littleweirdo-studio/little-squeaky-machine-hardware/docs/specs.md

The Little Squeaky Machine is a hardware reference platform for the [Little Weirdo software synthesizer](https://github.com/hi-squeaky-things/little-weirdo).

## Background

We were part of the Dutch house scene in the '90s, building real-time hardware and software for music and game projects. As electronic music enthusiasts, we couldn't help collecting phat-sounding synthesizers.

Decades later, we still love electronic music, even though we sold our synthesizer collection—a decision we regret. We wanted to create affordable, open-source electronic instruments that are accessible to everyone. By combining Rust (❤️ :fontawesome-brands-rust:) with low-cost microcontrollers (:simple-espressif: ESP32S3 / :simple-riscv: based ESP32S31), we aim to get into the groove and give back to the community.

With this in mind, we designed and built the hardware and software.

## Little Squeaky Machine Hardware

### Specifications and capabilities

| Subsystem | Component | Description |
| --- | --- | --- |
| Microcontroller | [ESP32-S3-WROOM-1](https://documentation.espressif.com/esp32-s3-wroom-1_wroom-1u_datasheet_en.pdf) | Runs the Little Weirdo firmware and manages the device's sound generation and controls. The MCU has two cores clocked at 240 MHz, making it well suited to separating sound generation, powered by the [Little Weirdo software synthesizer](https://github.com/hi-squeaky-things/little-weirdo), from control tasks. |
| Audio codec | [SGTL5000](https://www.nxp.com/docs/en/data-sheet/SGTL5000.pdf) | Provides stereo line input and output, microphone input with bias, and a capless stereo headphone amplifier with mixing and filtering. Its mixing matrix makes it easy to route microphone and line inputs into the audio signal chain. The SGTL5000 also includes digital filters for EQ and virtual surround sound. |
| Capacitive touch | [CY8CMBR3108](https://www.infineon.com/assets/row/public/documents/30/49/infineon-cy8cmbr3002-cy8cmbr3102-cy8cmbr3106s-cy8cmbr3108-cy8cmbr3110-cy8cmbr3116-datasheet-en.pdf) | Provides eight capacitive touch inputs over I²C, accessible through an edge connector. |
| TRS MIDI | [ESP32-S3-WROOM-1](https://documentation.espressif.com/esp32-s3-wroom-1_wroom-1u_datasheet_en.pdf) | Supports MIDI communication through TRS-A connections. |
| USB MIDI | [ESP32-S3-WROOM-1](https://documentation.espressif.com/esp32-s3-wroom-1_wroom-1u_datasheet_en.pdf) | Supports MIDI communication over USB-C. |
| Potentiometers and encoders | [ESP32-S3-WROOM-1](https://documentation.espressif.com/esp32-s3-wroom-1_wroom-1u_datasheet_en.pdf) | Provides hands-on controls, including four rotary encoders. |
| Motion sensor | [STK8321](https://uploadcdn.oneyac.com/attachments/files/brand_pdf/sensortek/STK8321.pdf) | Measures acceleration along three axes and communicates over I²C. |
| Keys | [CPG151101S11](https://www.lcsc.com/datasheet/C41430893.pdf) | Provides 25 hot-swappable tactile switches. |
| Display | [HS HS96L01W4S03](https://www.lcsc.com/datasheet/C5139758.pdf) | 0.96-inch OLED display with an SSD1315 controller and an I²C interface. |

## Schematics

The schematic source files and PCB layout (available for EasyEDA or KiCAD) can be found in the [:fontawesome-brands-github: Little Squeaky Machine Hardware repository](https://github.com/littleweirdo-studio/little-squeaky-machine-hardware/tree/main/fabrication).

### Processing

This schematic covers the ESP32-S3 and its supporting circuitry, including a USB-C-compliant interface, electrostatic discharge (ESD) and electromagnetic compatibility (EMC) protection, boot and reset buttons, and an OLED display. A resettable fuse provides additional protection for the 5 V rail that supplies the full-color LEDs.

Processing schematic

### Audio codec

This schematic shows the SGTL5000 audio codec and its supporting circuitry, including connectors, internal and external microphones, and a low-power, low-noise power supply.

Audio codec schematic

### LED controls

This schematic covers the circuitry used to control the machine's full-color LEDs.

LED controls schematic

### Key matrix controls

This schematic shows the key matrix and its connections to the 25 hot-swappable tactile switches.

Key matrix controls schematic

### Potentiometer and encoder controls

This schematic shows the connections for the four rotary encoders.

Potentiometer and encoder controls schematic

### MIDI input and output

This schematic covers the TRS-A MIDI input and output connections.

MIDI input and output schematic

### Touch controls

This schematic shows the capacitive touch controller and its connections, including the touch inputs accessible through the edge connector.

Touch controls schematic

### Motion sensing

This schematic shows the STK8321 three-axis accelerometer and its I²C connection.

Motion sensing schematic
