littleweirdo-studio/little-squeaky-machine-hardware/fabrication/v4/BOM_LttLMachineV4-Assembly-Order.xls

JLCPCB BOM Tool - BOM Matching
BOM name：BOM_LttLMachineV4-JLCPCB Assembly Order.xlsx |  |  | Download Time：2026-11-02 03:16:32 |  |  |  | * Our matching results are updated in real-time, but stock and prices may change. If it's been over 24 hours, please re-match before placing your order.
PCB Assembled Qty：5 |  |  | Est. Total Price：63.0858
Your BOM |  |  |  | Matched Parts |  |  |  |  |  |  | Order Information
Designator | Comment | Footprint | JLCPCB Part # | Matches | Part # | Manufacturer | Footprint | Description | Category | Warning | JLCPCB Part # | Product link | Lib Type | Qty | Source | Total Price ($)
C7 | 10uF | C0603 |  | Select by System | CGA0603X5R106K100JT | HRE | 0603 | 10V 10uF X5R ±10% 0603 Multilayer Ceramic Capacitors MLCC - SMD/SMT ROHS | Multilayer Ceramic Capacitors MLCC - SMD/SMT |  | C6119842 | https://jlcpcb.com/partdetail/HRE-CGA0603X5R106K100JT/C6119842 | Extended | 20 | 20 JLCPCB | 0.316
C8,C11,C16,C17,C20,C21,C29,C38,C39,C41,C45,CMIDI,CLED1,CLED2,CLED3,CLED4,CLED5,CLED6,CLED7,CLED8,CLED9,CLED10,CLED11,CLED12,CLED13,CLED14,CLED15,CLED16,CLED17,CLED18,CLED19,CLED20,CLED21,CLED22,CLED23,CLED24,CLED25,CLED26,CLED27,CLED28,CLED29 | 100nF | C0402 |  | Select by Customer | CL05B104KO5NNNC | Samsung Electro-Mechanics | 0402 | 100nF 16V X7R ±10% 0402 Multilayer Ceramic Capacitors MLCC - SMD/SMT ROHS | Multilayer Ceramic Capacitors MLCC - SMD/SMT | 1.There may be multiple types of parts, but one type of part has been matched. Please check.; | C1525 | https://jlcpcb.com/partdetail/1877-CL05B104KO5NNNC/C1525 | Basic | 225 | 225 JLCPCB | 0.72
C9,C35,C36,C37,C40 | 1uF | C0201 |  | Select by System | GRM033R61A105ME44D | Murata Electronics | 0201 | 10V 1uF X5R ±20% 0201 Multilayer Ceramic Capacitors MLCC - SMD/SMT ROHS | Multilayer Ceramic Capacitors MLCC - SMD/SMT |  | C76935 | https://jlcpcb.com/partdetail/MurataElectronics-GRM033R61A105ME44D/C76935 | Extended | 37 | 37 JLCPCB | 0.9287
C12,C14,C44 | 10uF | CASE-A_3216 |  | Select by System | CA45-A010M106T | Hunan Xiangyee in S&T | CASE-A-3216-16(mm) | -55℃~+125℃ 10V 10uF 3Ω@100kHz ±20% CASE-A-3216-16(mm) Tantalum Capacitors ROHS | Tantalum Capacitors |  | C127946 | https://jlcpcb.com/partdetail/Hunan_Xiangyee_in_ST-CA45A010M106T/C127946 | Extended | 19 | 19 JLCPCB | 2.1071
C13,C15 | 22uF | CASE-A_3216 |  | Select by System | CA45-A-10V-22uF-K | CEC(Shenzhen Zhenhua XinYun Elec) | CASE-A-3216-16(mm) | -55℃~+125℃ 10V 10Ω@100kHz 22uF ±10% CASE-A-3216-16(mm) Tantalum Capacitors ROHS | Tantalum Capacitors |  | C129272 | https://jlcpcb.com/partdetail/140558-CA45_A_10V_22uFK/C129272 | Extended | 14 | 14 JLCPCB | 1.8018
C18,C19,C25,C26,C27,C28,C30 | 2.2uF | C0402 |  | Select by System | CGA0402X5R225M6R3GT | HRE | 0402 | 2.2uF 6.3V X5R ±20% 0402 Multilayer Ceramic Capacitors MLCC - SMD/SMT ROHS | Multilayer Ceramic Capacitors MLCC - SMD/SMT |  | C7503516 | https://jlcpcb.com/partdetail/HRE-CGA0402X5R225M6R3GT/C7503516 | Extended | 45 | 45 JLCPCB | 0.198
C22 | 150nF | C0402 |  | Select by System | TCC0402X7R154K160AT | CCTC | 0402 | 150nF 16V X7R ±10% 0402 Multilayer Ceramic Capacitors MLCC - SMD/SMT ROHS | Multilayer Ceramic Capacitors MLCC - SMD/SMT |  | C7393865 | https://jlcpcb.com/partdetail/CCTC-TCC0402X7R154K160AT/C7393865 | Extended | 20 | 20 JLCPCB | 0.066
C43 | 2.2nF | C0805 |  | Select by System | CL21C222JBFNNNE | Samsung Electro-Mechanics | 0805 | 2.2nF 50V C0G ±5% 0805 Multilayer Ceramic Capacitors MLCC - SMD/SMT ROHS | Multilayer Ceramic Capacitors MLCC - SMD/SMT |  | C28260 | https://jlcpcb.com/partdetail/29010-CL21C222JBFNNNE/C28260 | Basic | 9 | 9 JLCPCB | 0.3033
C46 | 10nF | C0603 |  | Select by System | CGA0603X7R103M500JT | HRE | 0603 | 10nF 50V X7R ±20% 0603 Multilayer Ceramic Capacitors MLCC - SMD/SMT ROHS | Multilayer Ceramic Capacitors MLCC - SMD/SMT |  | C36911427 | https://jlcpcb.com/partdetail/HRE-CGA0603X7R103M500JT/C36911427 | Extended | 20 | 20 JLCPCB | 0.082
CODEC | SGTL5000XNLA3R2 | QFN-20_L3.0-W3.0-P0.40-BL-EP1.7 |  | Select by System | SGTL5000XNLA3R2 | NXP Semicon | QFN-20-EP(3x3) | -40℃~+85℃ 1.62V~3.6V 8kHz~96kHz Built-in phase-locked loop、On-chip digital gain、Mute control Encoder/decoder I2S、I2C、SPI QFN-20-EP(3x3) Audio Interface ICs ROHS | Audio Interface ICs |  | C2651833 | https://jlcpcb.com/partdetail/NXPSemicon-SGTL5000XNLA3R2/C2651833 | Extended | 5 | 5 My Parts | 0
D1 | SS34 | SMA_L4.3-W2.6-LS5.2-RD |  | Select by System | SS34 | MDD(Microdiode Semiconductor) | SMA(DO-214AC) | -55℃~+125℃ 3A 40V 500uA@40V 550mV@3A Independent SMA(DO-214AC) Schottky Diodes ROHS | Schottky Diodes |  | C8678 | https://jlcpcb.com/partdetail/MDD_Microdiode_Semiconductor-SS34/C8678 | Basic | 13 | 13 JLCPCB | 0.4576
D2 | 1N914W | SOD-123_L2.7-W1.6-LS3.7-RD-1 |  | Select by System | 1N914W | CBI | SOD-123 | 100V 1V@10mA 200mA 400mW 50ns 5uA@75V Independent SOD-123 Switching Diodes ROHS | Switching Diodes |  | C2836060 | https://jlcpcb.com/partdetail/CBI-1N914W/C2836060 | Extended | 20 | 20 JLCPCB | 0.22
D3,D4,D5,D6,D7 | ESD5451N | DFN1006-2L-BI |  | Select by System | ESD5451N | FUXINSEMI | DFN1006-2L | -55℃~+125℃ 1 100nA 11V 15pF 5.6V 5V 80W@8/20us 8A@8/20us Bidirectional IEC 61000-4-2、IEC 61000-4-5 TVS DFN1006-2L ESD and Surge Protection (TVS/ESD) ROHS |  |  | C20418114 | https://jlcpcb.com/partdetail/FUXINSEMI-ESD5451N/C20418114 | Extended | 35 | 35 JLCPCB | 0.1225
EDGE_CONNECTOR | X2549WR-2x10A-PTV01 | CONN-TH_20P-P2.54_X2549WR-2X10A-PTV01 |  | Select by System | X2549WR-2x10A-PTV01 | XKB Connection | 弯插,P=2.54mm | -55℃~+85℃ 14.5mm 2.54mm 20P 32mm 3A 9.2mm Copper Alloy Gold Right Angle Push-Pull,P=2.54mm Edgeboard Connectors ROHS | Edgeboard Connectors |  | C21261721 | https://jlcpcb.com/partdetail/XKBConnection-X2549WR_2x10APTV01/C21261721 | Extended | 5 | 5 My Parts | 0
ENCO0,ENCO1,ENCO2,ENCO3 | EC12E24404A8 | SW-TH_EC12EXXXX |  | Select by System | EC12E24404A8 | ALPSALPINE | 插件 | 插件 Rotary Encoders ROHS | Rotary Encoders |  | C470600 | https://jlcpcb.com/partdetail/ALPSALPINE-EC12E24404A8/C470600 | Extended | 20 | 20 JLCPCB | 11.484
ESP32S3 | ESP32-S3-WROOM-1-N16R8 | WIRELM-SMD_ESP32-S3-WROOM-1 |  | Select by System | ESP32-S3-WROOM-1-N16R8 | Espressif Systems | SMD,25.5x18mm | -103.5dBm -40℃~+65℃ 2.4GHz 20.5dBm 355mA 3V~3.6V 95mA ESP32-S3R8 On-board PCB Antenna UART、SPI、I2C、GPIO、I2S、USB SMD,25.5x18mm WiFi Modules ROHS | WiFi Modules |  | C2913202 | https://jlcpcb.com/partdetail/3198300-ESP32_S3_WROOM_1N16R8/C2913202 | Extended | 5 | 5 My Parts | 0
FUSE | SMD1812-300C-16V | F1812 |  | Select by System | SMD1812-300C-16V | BNstar | 1812 | -40℃~+85℃ 1.5mm 100A 10mΩ 16V 3.41mm 3A 4.73mm 40mΩ 4s 6A 800mW 1812 Resettable Fuses ROHS | Resettable Fuses |  | C2760295 | https://jlcpcb.com/partdetail/BNstar-SMD1812_300C16V/C2760295 | Extended | 7 | 7 JLCPCB | 0.6755
GYRO | STK8321 | LGA-12_L2.0-W2.0-P0.50-TR |  | Select by System | STK8321 | SENSORTEK | LGA-12(2x2) | -40℃~+85℃ 1.7V~3.6V 12bit 1uA Accelerometer SPI、I2C X,Y,Z ±8g 运动事件检测 LGA-12(2x2) Accelerometers ROHS | Accelerometers |  | C966924 | https://jlcpcb.com/partdetail/SENSORTEK-STK8321/C966924 | Extended | 5 | 5 JLCPCB | 2.346
HEADPHONE,MIDI-IN,MIDI-OUT | PJ-3062-HD-B | AUDIO-TH_PJ-3062-HD-B |  | Select by Customer | PJ-3062-HD-B | XKB Connection | 插件 | -20℃~+70℃ 12mm 15.01mm 3.5mm Headphone Jack 30V 500mA 9.35mm Black Phosphor bronze Right-Angle TRS Tin Plugin Audio Connectors ROHS | Audio Connectors (Headphones) | 1.There may be multiple types of parts, but one type of part has been matched. Please check.; | C692443 | https://jlcpcb.com/partdetail/XKBConnection-PJ_3062_HDB/C692443 | Extended | 15 | 15 My Parts | 0
KEY_1,KEY_2,KEY_3,KEY_4,KEY_5,KEY_6,KEY_7,KEY_8,KEY_9,KEY_10,KEY_11,KEY_12,KEY_13,KEY_14,KEY_15,KEY_16,KEY_17,KEY_18,KEY_19,KEY_20,KEY_21,KEY_22,KEY_23,KEY_24,KEY_25 | CPG151101S11-16 | SMD_KEYBOARD-SW |  | Select by System | CPG151101S11-16 | HanElectricity | SMD,14.5x5.9mm | 12V 2 3000gf 5,000 cycles SMD,14.5x5.9mm Mechanical Keyboard Shaft ROHS | Mechanical Keyboard Shaft |  | C41430893 | https://jlcpcb.com/partdetail/HanElectricity-CPG151101S1116/C41430893 | Extended | 127 | 127 JLCPCB | 4.699
KEY_D1,KEY_D2,KEY_D3,KEY_D4,KEY_D5,KEY_D6,KEY_D7,KEY_D8,KEY_D9,KEY_D10,KEY_D11,KEY_D12,KEY_D13,KEY_D14,KEY_D15,KEY_D16,KEY_D17,KEY_D18,KEY_D19,KEY_D20,KEY_D21,KEY_D22,KEY_D23,KEY_D24 | 1N4148WS | SOD-323_L1.8-W1.3-LS2.5-RD |  | Select by System | 1N4148WS | Guangdong Hottech | SOD-323 | 1.25V@150mA 150mA 1uA@75V 200mW 2A 4ns 75V Standalone SOD-323 Switching Diodes ROHS | Switching Diodes |  | C181133 | https://jlcpcb.com/partdetail/GuangdongHottech-1N4148WS/C181133 | Extended | 130 | 130 JLCPCB | 1.235
L1 | HCB2012KV-601T20 | L0805 |  | Select by System | HCB2012KV-601T20 | TAI-TECH | 0805 | 600Ω ±25% 0805 Ferrite Beads ROHS | Ferrite Beads |  | C5139902 | https://jlcpcb.com/partdetail/TAITECH-HCB2012KV601T20/C5139902 | Extended | 20 | 20 JLCPCB | 0.494
L2 | BLM15PX330SN1D | L0402 |  | Select by System | BLM15PX330SN1D | Murata Electronics | 0402 | 1 22mΩ 33Ω@100MHz 3A ±25% 0402 Ferrite Beads ROHS | Ferrite Beads |  | C160974 | https://jlcpcb.com/partdetail/MurataElectronics-BLM15PX330SN1D/C160974 | Extended | 20 | 20 JLCPCB | 0.382
LDO | AMS1117-3.3 | SOT-223-4_L6.5-W3.5-P2.30-LS7.0-BR |  | Select by System | AMS1117-3.3 | UMW(Youtai Semiconductor Co., Ltd.) | SOT-223 | -40℃~+125℃ 0.003%Vout 1 1.3V@(1A) 12V 1A 3.3V 5mA 60dB@(120Hz) Fixed Over Current Protection Positive SOT-223 Voltage Regulators - Linear, Low Drop Out (LDO) Regulators ROHS | Voltage Regulators - Linear, Low Drop Out (LDO) Regulators |  | C347222 | https://jlcpcb.com/partdetail/323882-AMS1117_33/C347222 | Extended | 6 | 6 My Parts | 0
LED1,LED2,LED3,LED4,LED5,LED6,LED7,LED8,LED9,LED10,LED11,LED12,LED13,LED14,LED15,LED16,LED17,LED18,LED19,LED20,LED21,LED22,LED23,LED24,LED25,LED26,LED27,LED28,LED29 | SK6812MINI-E | LED-SMD_4P-L3.2-W2.8-LS5.9_SK6812MINI-E |  | Select by System | SK6812MINI-E | OPSCO Optoelectronics | SMD | -40℃~+85℃ 0.6mA 1.78mm 120mcd~240mcd 120° 160mcd~320mcd 1kHz 2.8mm 2000V 3.2mm 3.7V~5.5V 460nm~470nm 515nm~525nm 620nm~625nm 800Kbit/s 815mcd~1275mcd Semi-transparent lens SMD RGB LEDs(Built-in IC) ROHS | RGB LEDs(Built-In IC) |  | C5149201 | https://jlcpcb.com/partdetail/OPSCOOptoelectronics-SK6812MINIE/C5149201 | Extended | 149 | 149 JLCPCB | 9.685
LINE-IN,MIC_EXTERNAL | PJ-3062-HD-R | AUDIO-TH_XKB_PJ-3062-HD-R |  | Select by Customer | PJ-3062-HD-R | XKB Connection | 插件 | -20℃~+70℃ 3.5mm Headphone Jack 30V 500mA 插件 Audio Connectors ROHS | Audio Connectors (Headphones) | 1.There may be multiple types of parts, but one type of part has been matched. Please check.; | C668225 | https://jlcpcb.com/partdetail/XKBConnection-PJ_3062_HDR/C668225 | Extended | 10 | 10 JLCPCB | 3.741
LINE-OUT | PJ-3062-HD-G | AUDIO-TH_PJ-3062-HD-G |  | Select by System | PJ-3062-HD-G | XKB Connection | 插件 | -20℃~+70℃ 3.5mm Headphone Jack 30V 500mA 插件 Audio Connectors ROHS | Audio Connectors (Headphones) |  | C431042 | https://jlcpcb.com/partdetail/XKBConnection-PJ_3062_HDG/C431042 | Extended | 5 | 5 JLCPCB | 1.761
MIC_INTERNAL | KEAG4544PF-K | MIC-TH_BD9.7-P2.50-D0.8-L-FD |  | Select by Customer | KEAG4544PF-K | KINGSTATE | 插件,D=9.7mm | -20℃~+70℃ -44dB@±3dB 2.2kΩ 2.54mm 20Hz~20000Hz 3V 4.5mm 500uA 60dB 9.7mm Omnidirectional Plug-in Plugin,D=9.7mm Microphones ROHS | Microphones |  | C7430174 | https://jlcpcb.com/partdetail/KINGSTATE-KEAG4544PFK/C7430174 | Extended | 5 | 5 JLCPCB | 2.51
MIC_SELECT | XKB5858-Z-F-75 | SW-SMD_XKB5858-Z-F-75 |  | Select by System | XKB5858-Z-F-75 | XKB Connection | SMD | -15℃~+55℃ 100,000 cycles 100mA 2.5N 30V Gull Wing Latching Square Button Surface Mount, Right Angle White Without SMD Pushbutton Switches ROHS | Pushbutton Switches |  | C2884736 | https://jlcpcb.com/partdetail/XKBConnection-XKB5858_Z_F75/C2884736 | Extended | 5 | 5 JLCPCB | 1.6265
OLED | HS96L03W2C03 | OLED-TH_L27.8-W27.2-P2.54_C9900033791 |  | Select by Customer | HS96L03W2C03 | HS | - | -40℃~+70℃ 0.96 128x64 180cd/m2 21.744x10.864mm I2C Passive (PMOLED) SSD1315 chip White - OLED Display ROHS | OLED Display |  | C5248080 | https://jlcpcb.com/partdetail/HS-HS96L03W2C03/C5248080 | Extended | 5 | 5 My Parts | 0
OPTOC | 6N137S1(TA) | SMD-8_L9.8-W6.6-P2.54-LS10.3-BL |  | Select by System | 6N137S1(TA) | Everlight Elec | SOP-8-2.54mm | -40℃~+85℃ 1 1.4V 100mW 10Mbps 10kV/us 4.5V~5.5V 5kV 5mA 75ns 75ns DC SOP-8-2.54mm Logic Output Optoisolators ROHS | Optocouplers |  | C110020 | https://jlcpcb.com/partdetail/EverlightElec-6N137S1_TA/C110020 | Extended | 5 | 5 JLCPCB | 1.558
R1,R2 | 5.1kΩ | R0603 |  | Select by System | 0603WAF5101T5E | UNI-ROYAL(Uniroyal Elec) | 0603 | -55℃~+155℃ 100mW 5.1kΩ 75V Thick Film Resistor ±1% ±100ppm/℃ 0603 Chip Resistor - Surface Mount ROHS | Chip Resistor - Surface Mount |  | C23186 | https://jlcpcb.com/partdetail/23913-0603WAF5101T5E/C23186 | Basic | 20 | 20 JLCPCB | 0.03
R3 | 10kΩ | R0402 |  | Select by System | SCR0402J10K | VO | 0402 | -55℃~+155℃ 10kΩ 50V 62.5mW Thick Film Resistor ±200ppm/℃ ±5% 0402 Chip Resistor - Surface Mount ROHS | Chip Resistor - Surface Mount |  | C3017497 | https://jlcpcb.com/partdetail/VO-SCR0402J10K/C3017497 | Extended | 20 | 20 JLCPCB | 0.01
R5,R6,R8 | 2.2kΩ | R0603 |  | Select by System | 0603WAF2201T5E | UNI-ROYAL(Uniroyal Elec) | 0603 | -55℃~+155℃ 100mW 2.2kΩ 75V Thick Film Resistor ±1% ±100ppm/℃ 0603 Chip Resistor - Surface Mount ROHS | Chip Resistor - Surface Mount |  | C4190 | https://jlcpcb.com/partdetail/4597-0603WAF2201T5E/C4190 | Basic | 25 | 25 JLCPCB | 0.045
R7 | 100Ω | R0603 |  | Select by System | RC0603FR-07100RL | YAGEO | 0603 | -55℃~+155℃ 100mW 100Ω 75V Thick Film Resistor ±1% ±100ppm/℃ 0603 Chip Resistor - Surface Mount ROHS | Chip Resistor - Surface Mount |  | C105588 | https://jlcpcb.com/partdetail/YAGEO-RC0603FR07100RL/C105588 | Extended | 20 | 20 JLCPCB | 0.038
R9 | 220Ω | R0603 |  | Select by System | SCR0603J220R | VO | 0603 | -55℃~+155℃ 100mW 220Ω 75V Thick Film Resistor ±200ppm/℃ ±5% 0603 Chip Resistor - Surface Mount ROHS | Chip Resistor - Surface Mount |  | C3017752 | https://jlcpcb.com/partdetail/VO-SCR0603J220R/C3017752 | Extended | 20 | 20 JLCPCB | 0.02
R10 | 470Ω | R0603 |  | Select by Customer | 0603WAF4700T5E | UNI-ROYAL(Uniroyal Elec) | 0603 | -55℃~+155℃ 100mW 470Ω 75V Thick Film Resistor ±1% ±100ppm/℃ 0603 Chip Resistor - Surface Mount ROHS | Chip Resistor - Surface Mount |  | C23179 | https://jlcpcb.com/partdetail/23906-0603WAF4700T5E/C23179 | Basic | 20 | 20 JLCPCB | 0.046
R12 | 33Ω | R0603 |  | Select by System | 0603WAF330JT5E | UNI-ROYAL(Uniroyal Elec) | 0603 | -55℃~+155℃ 100mW 33Ω 75V Thick Film Resistor ±1% ±100ppm/℃ 0603 Chip Resistor - Surface Mount ROHS | Chip Resistor - Surface Mount |  | C23140 | https://jlcpcb.com/partdetail/23867-0603WAF330JT5E/C23140 | Basic | 20 | 20 JLCPCB | 0.048
R13 | 10Ω | R0603 |  | Select by System | QR0603J10R0P05Z | Ever Ohms Tech | 0603 | -55℃~+155℃ 100mW 10Ω 75V Thick Film Resistor ±100ppm/℃ ±5% 0603 Chip Resistor - Surface Mount ROHS | Chip Resistor - Surface Mount |  | C176153 | https://jlcpcb.com/partdetail/Ever_OhmsTech-QR0603J10R0P05Z/C176153 | Extended | 20 | 20 JLCPCB | 0.078
R14,R15,R18 | 22Ω | R0603 |  | Select by System | 0603WAF220JT5E | UNI-ROYAL(Uniroyal Elec) | 0603 | -55℃~+155℃ 100mW 22Ω 75V Thick Film Resistor ±1% ±100ppm/℃ 0603 Chip Resistor - Surface Mount ROHS | Chip Resistor - Surface Mount |  | C23345 | https://jlcpcb.com/partdetail/24078-0603WAF220JT5E/C23345 | Basic | 25 | 25 JLCPCB | 0.0425
R19,R20,R21,R22,R23,R24,R25,R26,R27 | 500Ω | R0603 |  | Select by System | RT0603BRD07500RL | YAGEO | 0603 | -55℃~+155℃ 100mW 500Ω Thin Film Resistor ±0.1% ±25ppm/℃ 0603 Chip Resistor - Surface Mount ROHS | Chip Resistor - Surface Mount |  | C6207671 | https://jlcpcb.com/partdetail/YAGEO-RT0603BRD07500RL/C6207671 | Extended | 66 | 66 JLCPCB | 4.2372
RESET | XKB5858-W-F-75 | SW-SMD_XKB5858-W-F-75 |  | Select by System | XKB5858-W-F-75 | XKB Connection | SMD | -15℃~+55℃ 100,000 cycles 100mA 2.5N 30V Gull Wing Non-Latching Square Button Surface Mount, Right Angle White Without SMD Pushbutton Switches ROHS | Pushbutton Switches |  | C780037 | https://jlcpcb.com/partdetail/XKBConnection-XKB5858_W_F75/C780037 | Extended | 5 | 5 JLCPCB | 1.5365
TOUCH | CY8CMBR3108-LQXI | QFN-16_L3.0-W3.0-P0.50-BL-EP1.7 |  | Select by System | CY8CMBR3108-LQXI | Infineon/Cypress Semicon | QFN-16-EP(3x3) | -40℃~+85℃ 1.71V~5.5V 8 Capacitive Touch、PWM Control、自动灵敏度校准、防水抗干扰触摸、接近检测 QFN-16-EP(3x3) Touch Sensors ROHS | Touch Sensors |  | C511139 | https://jlcpcb.com/partdetail/525970-CY8CMBR3108LQXI/C511139 | Extended | 5 | 5 JLCPCB | 4.1585
U1 | AMS1117-1.8 | SOT-223_L6.7-W3.5-P2.30-BR |  | Select by System | AMS1117-1.8 | UMW(Youtai Semiconductor Co., Ltd.) | SOT-223 | -40℃~+125℃ 0.003%Vout 1 1.3V@(1A) 1.8V 18V 1A 5mA 60dB@(120Hz) Fixed Over Current Protection Positive SOT-223 Voltage Regulators - Linear, Low Drop Out (LDO) Regulators ROHS | Voltage Regulators - Linear, Low Drop Out (LDO) Regulators |  | C347220 | https://jlcpcb.com/partdetail/323880-AMS1117_18/C347220 | Extended | 9 | 9 My Parts | 0
U2 | GT74LVC2T45V8 | VSSOP-8_L2.3-W2.0-P0.50-LS3.1-BL |  | Select by System | GT74LVC2T45V8 | GTIC | VSSOP-8 | -40℃~+125℃ 1.65V~5.5V 1.65V~5.5V 2 Bidirectional Level translator Power-off protection、Output enable high-impedance Tri-State VSSOP-8 Translators, Level Shifters ROHS | Buffers, Drivers, Receivers, Transceivers |  | C22356905 | https://jlcpcb.com/partdetail/GTIC-GT74LVC2T45V8/C22356905 | Extended | 7 | 7 JLCPCB | 0.8561
USB | TYPEC-304YSSW-ACP16 | USB-SMD_TYPEC-304YSSW-ACP16 |  | Select by System | TYPEC-304YSSW-ACP16 | XUNPU | SMD | -25℃~+85℃ 1 10000 times 16P 5A 5V 7.35mm Black Female Surface Mount, Right Angle Type-C SMD USB Connectors ROHS | USB Connectors |  | C2840392 | https://jlcpcb.com/partdetail/XUNPU-TYPEC_304YSSWACP16/C2840392 | Extended | 5 | 5 JLCPCB | 2.42
