littleweirdo-studio/little-squeaky-machine-hardware/fabrication/v2/top.stl

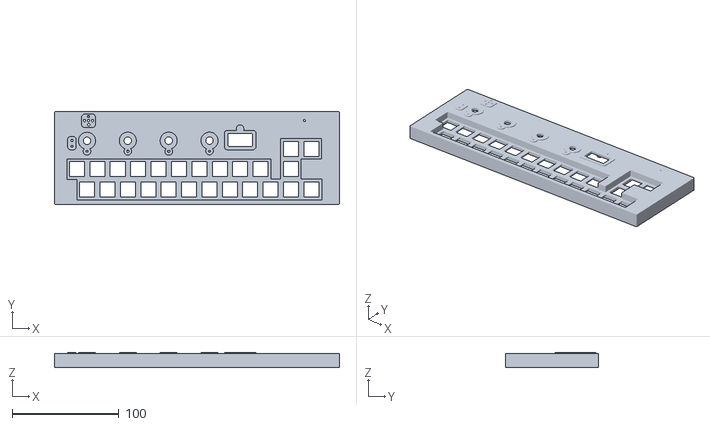
[picture p14: CAD file, 2026-11-07, an earlier design]
fabrication/v2/top.stl
267.1 x 87.0 x 14.0
