littleweirdo-studio/little-squeaky-machine-hardware/fabrication/v3/top.stl

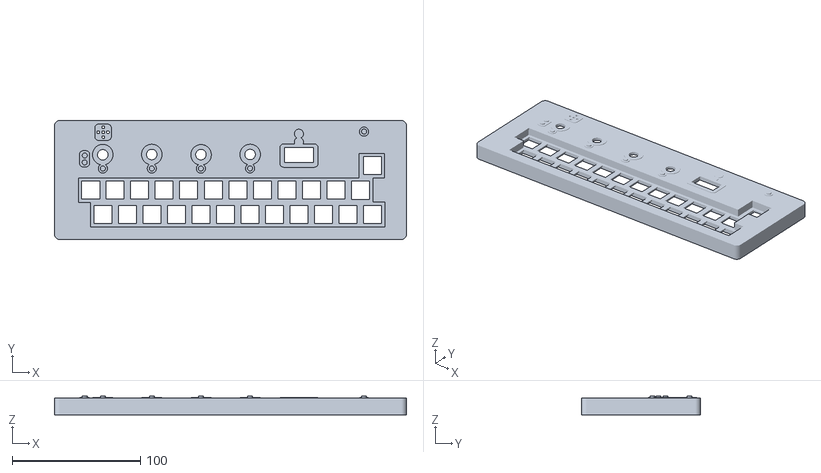
[picture p15: CAD file, 2026-11-06, an earlier design]
fabrication/v3/top.stl
274.5 x 92.7 x 14.5
