littleweirdo-studio/little-squeaky-machine-hardware/fabrication/v2/bottom.stl

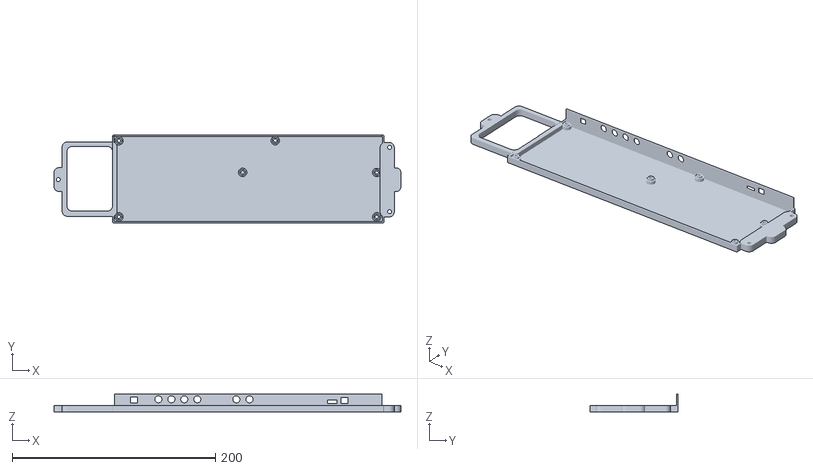
[picture p16: CAD file, 2026-11-07, an earlier design]
fabrication/v2/bottom.stl
341.9 x 87.0 x 17.5
