littleweirdo-studio/little-squeaky-machine-hardware/fabrication/v3/bottom.stl

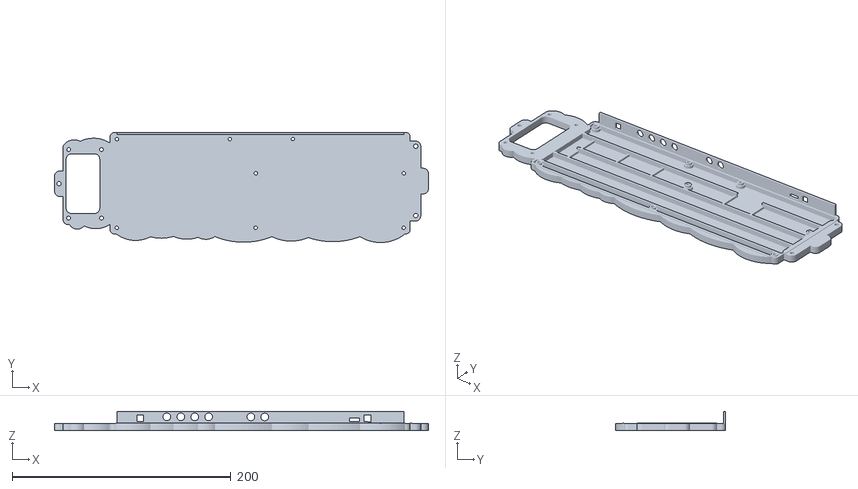
[picture p17: CAD file, 2026-11-06, an earlier design]
fabrication/v3/bottom.stl
341.9 x 100.6 x 17.5
