littleweirdo-studio/little-squeaky-machine-hardware/(list of files, drawings)

Other design files:
fabrication/v1/little_squeaky_machine.eprj
fabrication/v2/little_squeaky_machine.epro
