littleweirdo-studio/little-squeaky-machine-hardware/fabrication/v4/kicad_little_squeaky_machine/1_Processing.kicad_sch

## KiCad design fabrication/v4/kicad_little_squeaky_machine/1_Processing.kicad_sch (2026-11-06)

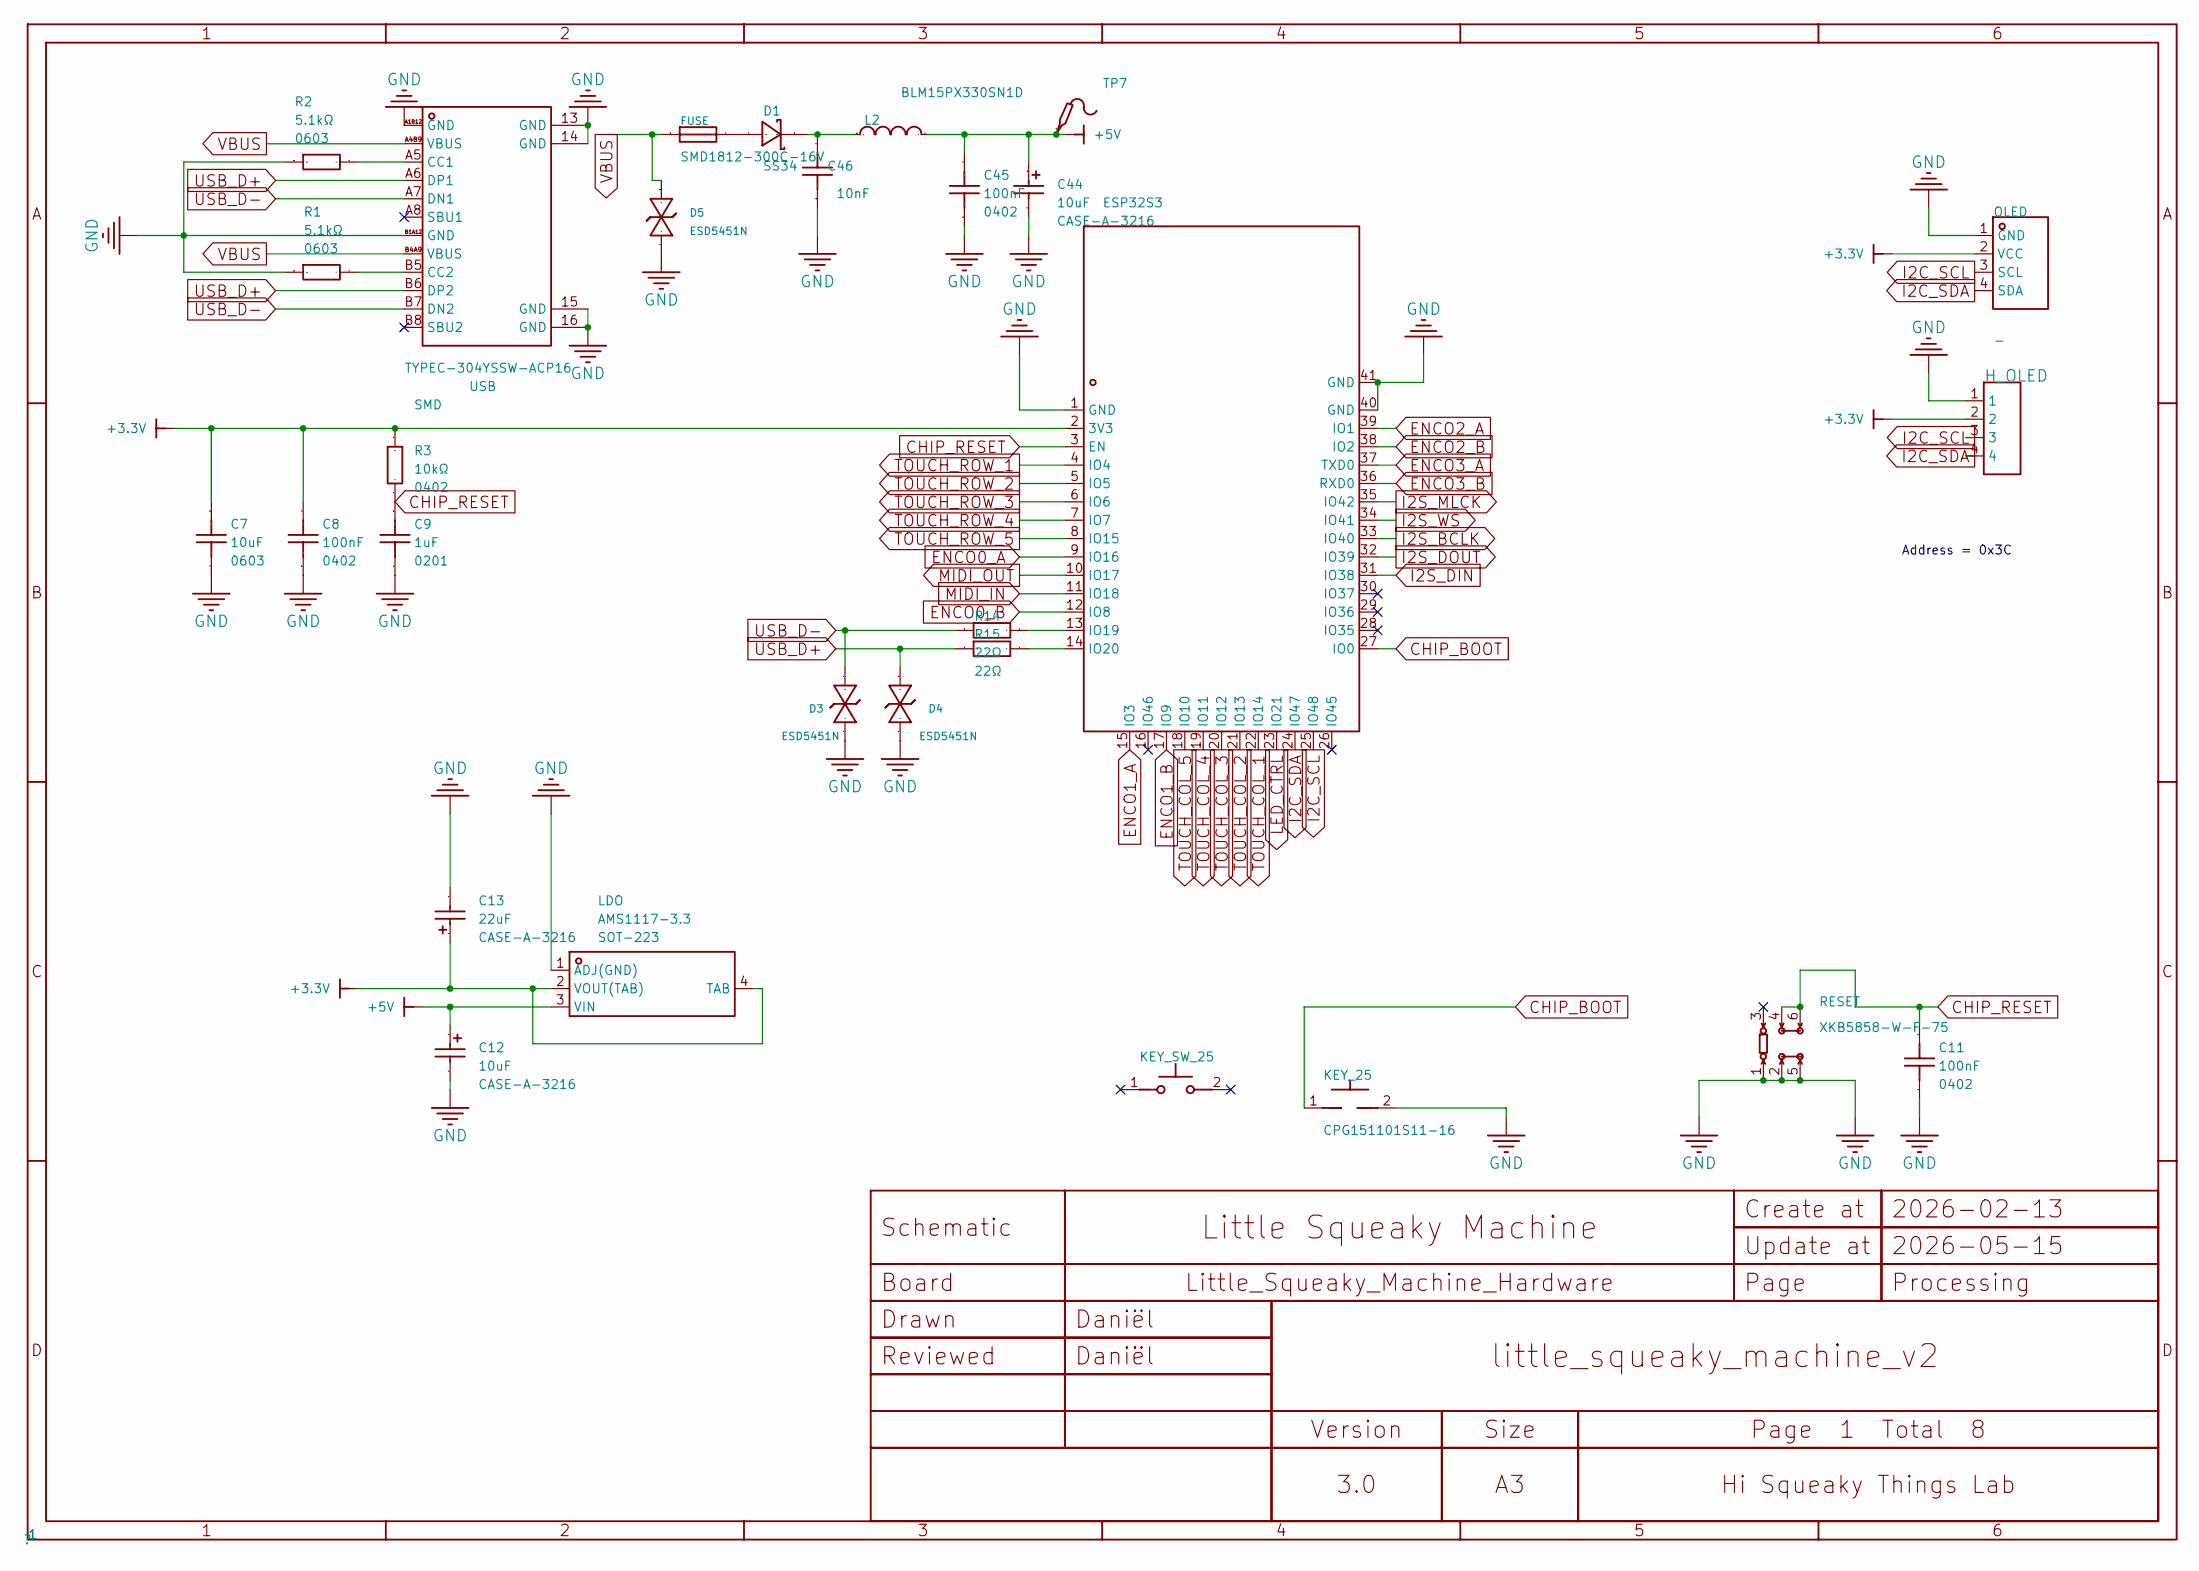
[picture p18: schematic 1_Processing.kicad_sch]

Parts:
C7: 10uF; C0603; Manufacturer Part CGA0603X5R106K100JT; LCSC Part Name 10uF ±10% 10V
C8, C11, C45: 100nF; C0402; Voltage Rating 16V; Manufacturer Part CL05B104KO5NNNC; LCSC Part Name 100nF ±10% 16V
C9: 1uF; C0603; Manufacturer Part GRM033R61A105ME44D; LCSC Part Name 1uF ±20% 10V
C12, C44: 10uF; CASE-A_3216; Manufacturer Part CA45-A010M106T; LCSC Part Name 10uF ±20% 10V
C13: 22uF; CASE-A_3216; Manufacturer Part CA45-A-10V-22uF-K; LCSC Part Name 22uF ±10% 10V
C46: 10nF; C0603; Manufacturer Part CGA0603X7R103M500JT; LCSC Part Name 10nF ±20% 50V
D1: SS34; SMA_L4.3-W2.6-LS5.2-RD; Manufacturer Part SS34; LCSC Part Name 电压:40V 电流:3A
D3, D4, D5: ESD5451N; DFN1006-2L-BI; Manufacturer Part ESD5451N; LCSC Part Name ESD5451N
ESP32S3: ESP32-S3-WROOM-1-N16R8; WIRELM-SMD_ESP32-S3-WROOM-1; Manufacturer Part ESP32-S3-WROOM-1-N16R8; LCSC Part Name 通用型Wi-Fi+低功耗蓝牙MCU模组
FUSE: SMD1812-300C-16V; F1812; Manufacturer Part SMD1812-300C-16V; LCSC Part Name 16V 3A 1812自恢复
H_OLED: PZ254V-21-04-A30-1300; HDR-TH_4P-P2.54-V-M_1; Current Rating 3A; Manufacturer Part PZ254V-21-04-A30-1300; LCSC Part Name 1x4P 间距:2.54mm 方针 直插
KEY_25: CPG151101S11-16; SMD_KEYBOARD-SW; Voltage Rating 12V; Manufacturer Part CPG151101S11-16; LCSC Part Name 热插拔底座连接器 键盘配件
KEY_SW_25: CPG1511F01S04; KEY-TH_CPG1511F01S0X; Manufacturer Part CPG1511F01S04; LCSC Part Name BOX 红轴
L2: BLM15PX330SN1D; L0402; Manufacturer Part BLM15PX330SN1D; LCSC Part Name 单路 0402磁珠 阻抗33Ω@100MHz
LDO: AMS1117-3.3; SOT-223-4_L6.5-W3.5-P2.30-LS7.0-BR; Manufacturer Part AMS1117-3.3; LCSC Part Name 输出:3.3V 电流:1A 耐压:12V
OLED: HS96L03W2C03; OLED-TH_L27.8-W27.2-P2.54_C9900033791; Manufacturer Part HS96L03W2C03; LCSC Part Name 0.96寸OLED显示屏窄白光IIC
R1, R2: 5.1kΩ; R0603; Manufacturer Part 0603WAF5101T5E; LCSC Part Name 5.1kΩ ±1% 100mW 厚膜电阻
R3: 10kΩ; R0603; Manufacturer Part SCR0402J10K; LCSC Part Name 厚膜电阻 10kΩ ±5% 62.5mW
R14, R15: 22Ω; R0603; Tolerance ±1%; Manufacturer Part 0603WAF220JT5E; LCSC Part Name 22Ω ±1% 100mW 厚膜电阻
RESET: XKB5858-W-F-75; SW-SMD_XKB5858-W-F-75; Manufacturer Part XKB5858-W-F-75; LCSC Part Name XKB5858-W-F-75
TP7: Test-Point-0.5mm
USB: TYPEC-304YSSW-ACP16; USB-SMD_TYPEC-304YSSW-ACP16; Manufacturer Part TYPEC-304YSSW-ACP16; LCSC Part Name Type-C 母 卧贴

Connections:
CHIP_BOOT: ESP32S3.27 (IO0), KEY_25.1
CHIP_RESET: C9.1, C11.2, ESP32S3.3 (EN), R3.2, RESET.4, RESET.6
ENCO0_A: ESP32S3.9 (IO16)
ENCO0_B: ESP32S3.12 (IO8)
ENCO1_A: ESP32S3.15 (IO3)
ENCO1_B: ESP32S3.17 (IO9)
ENCO2_A: ESP32S3.39 (IO1)
ENCO2_B: ESP32S3.38 (IO2)
ENCO3_A: ESP32S3.37 (TXD0)
ENCO3_B: ESP32S3.36 (RXD0)
I2C_SCL: ESP32S3.25 (IO48), H_OLED.3, OLED.3 (SCL)
I2C_SDA: ESP32S3.24 (IO47), H_OLED.4, OLED.4 (SDA)
I2S_BCLK: ESP32S3.33 (IO40)
I2S_DIN: ESP32S3.31 (IO38)
I2S_DOUT: ESP32S3.32 (IO39)
I2S_MLCK: ESP32S3.35 (IO42)
I2S_WS: ESP32S3.34 (IO41)
LED_CTRL: ESP32S3.23 (IO21)
MIDI_IN: ESP32S3.11 (IO18)
MIDI_OUT: ESP32S3.10 (IO17)
unnamed: C7.1, C8.2, ESP32S3.2 (3V3), R3.1
unnamed: C12.1, LDO.3 (VIN)
unnamed: C13.1, LDO.2 (VOUT(TAB)), LDO.4 (TAB)
unnamed: C44.1, C45.2, L2.2, TP7.1
unnamed: C46.2, D1.1 (K), L2.1
unnamed: D1.2 (A), FUSE.2
unnamed: ESP32S3.13 (IO19), R14.2
unnamed: ESP32S3.14 (IO20), R15.2
unnamed: ESP32S3.40 (GND), ESP32S3.41 (GND)
unnamed: R1.1, R2.1, USB.B1A12 (GND)
unnamed: R1.2, USB.B5 (CC2)
unnamed: R2.2, USB.A5 (CC1)
unnamed: RESET.1, RESET.2, RESET.5
unnamed: USB.13 (GND), USB.14 (GND)
unnamed: USB.15 (GND), USB.16 (GND)
TOUCH_COL_1: ESP32S3.22 (IO14)
TOUCH_COL_2: ESP32S3.21 (IO13)
TOUCH_COL_3: ESP32S3.20 (IO12)
TOUCH_COL_4: ESP32S3.19 (IO11)
TOUCH_COL_5: ESP32S3.18 (IO10)
TOUCH_ROW_1: ESP32S3.4 (IO4)
TOUCH_ROW_2: ESP32S3.5 (IO5)
TOUCH_ROW_3: ESP32S3.6 (IO6)
TOUCH_ROW_4: ESP32S3.7 (IO7)
TOUCH_ROW_5: ESP32S3.8 (IO15)
USB_D+: D4.1, R15.1, USB.A6 (DP1), USB.B6 (DP2)
USB_D-: D3.1, R14.1, USB.A7 (DN1), USB.B7 (DN2)
VBUS: D5.1, FUSE.1, USB.A4B9 (VBUS), USB.B4A9 (VBUS)

Notes on the sheet:
Address = 0x3C
