littleweirdo-studio/little-squeaky-machine-hardware/fabrication/v4/kicad_little_squeaky_machine/2_Audio Codec.kicad_sch

## KiCad design fabrication/v4/kicad_little_squeaky_machine/2_Audio Codec.kicad_sch (2026-11-06)

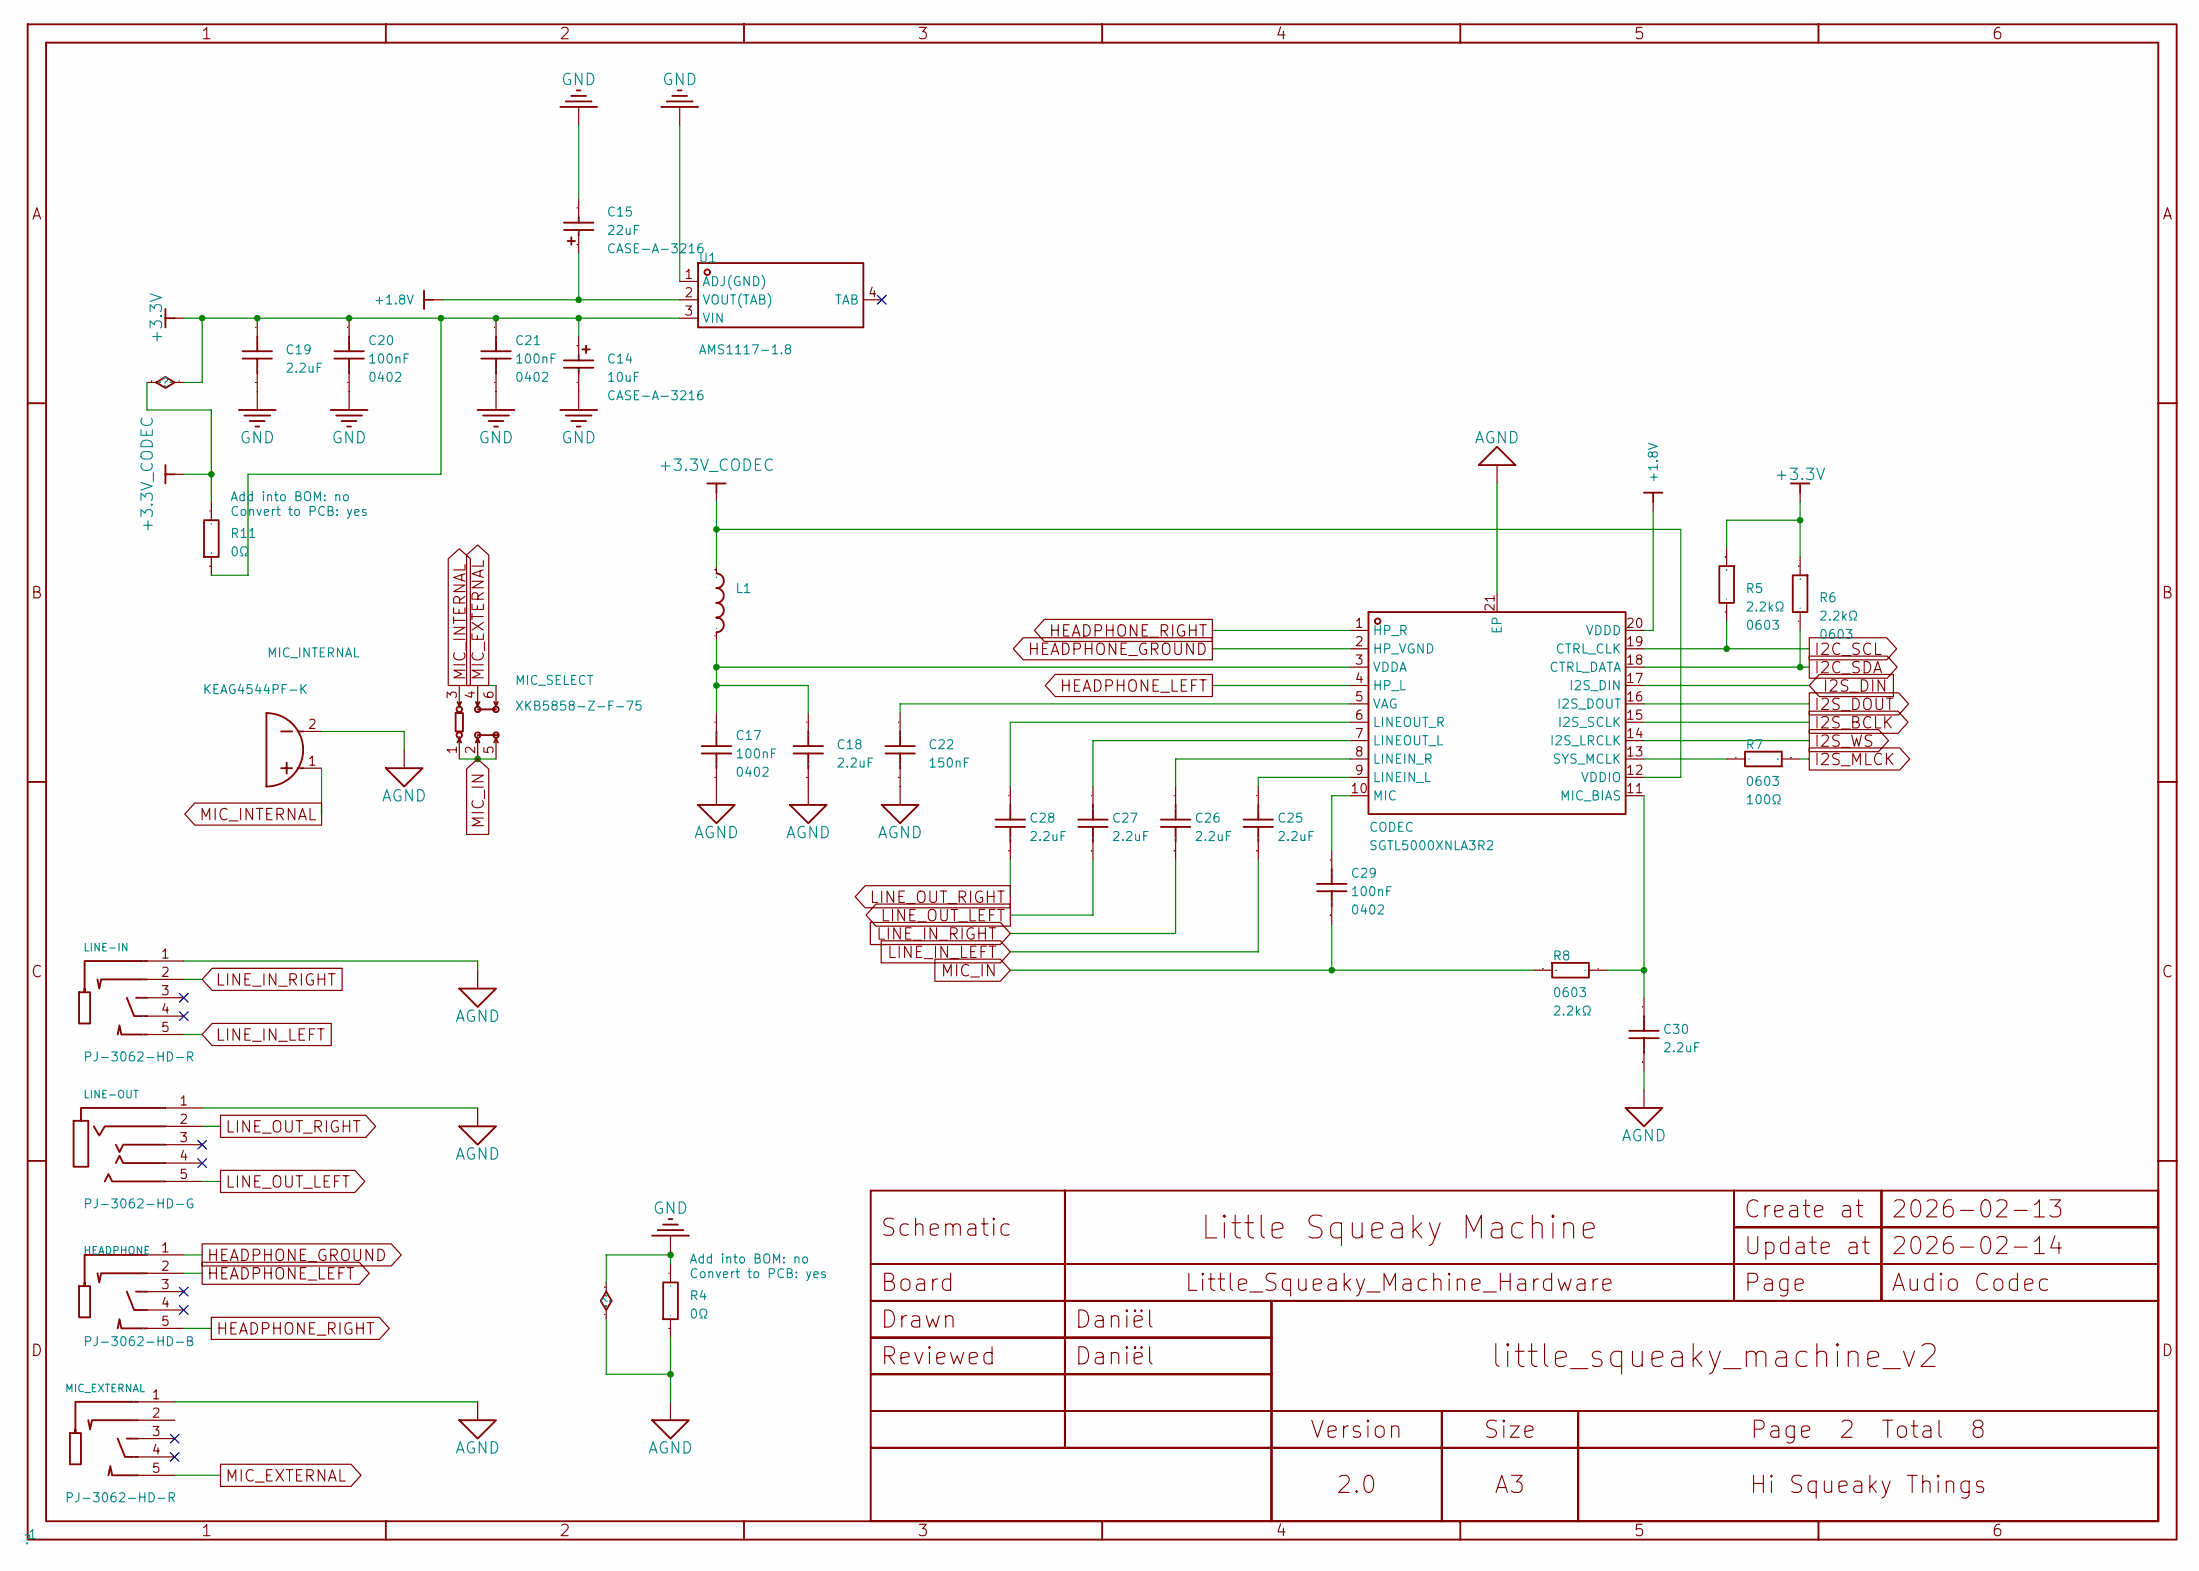
[picture p19: schematic 2_Audio Codec.kicad_sch]

Parts:
C14: 10uF; CASE-A_3216; Manufacturer Part CA45-A010M106T; LCSC Part Name 10uF ±20% 10V
C15: 22uF; CASE-A_3216; Manufacturer Part CA45-A-10V-22uF-K; LCSC Part Name 22uF ±10% 10V
C17, C20, C21, C29: 100nF; C0402; Voltage Rating 16V; Manufacturer Part CL05B104KO5NNNC; LCSC Part Name 100nF ±10% 16V
C18, C19, C25, C26, C27, C28, C30: 2.2uF; C0402; Manufacturer Part CGA0402X5R225M6R3GT; LCSC Part Name 2.2uF ±20% 6.3V
C22: 150nF; C0402; Manufacturer Part TCC0402X7R154K160AT; LCSC Part Name 150nF ±10% 16V
CODEC: SGTL5000XNLA3R2; QFN-20_L3.0-W3.0-P0.40-BL-EP1.7; Manufacturer Part SGTL5000XNLA3R2; LCSC Part Name 低功耗立体声编解码器带耳机放大器 SGTL5000
HEADPHONE: PJ-3062-HD-B; AUDIO-TH_PJ-3062-HD-B; Current Rating 500mA; Voltage Rating (Max) 30V; Manufacturer Part PJ-3062-HD-B; LCSC Part Name 黑色 3.5mm耳机座
L1: L0805; Manufacturer Part HCB2012KV-601T20; LCSC Part Name 车载品-2mm*1.2mm-600?-±25%
LINE-IN: PJ-3062-HD-R; AUDIO-TH_XKB_PJ-3062-HD-R; Current Rating 500mA; Voltage Rating (Max) 30V; Manufacturer Part PJ-3062-HD-R; LCSC Part Name 红色 3.5mm耳机座
LINE-OUT: PJ-3062-HD-G; AUDIO-TH_PJ-3062-HD-G; Current Rating 500mA; Voltage Rating (Max) 30V; Manufacturer Part PJ-3062-HD-G; LCSC Part Name 绿色 3.5mm耳机座
MIC_EXTERNAL: PJ-3062-HD-R; AUDIO-TH_XKB_PJ-3062-HD-R; Current Rating 500mA; Voltage Rating (Max) 30V; Manufacturer Part PJ-3062-HD-R; LCSC Part Name 红色 3.5mm耳机座
MIC_INTERNAL: KEAG4544PF-K; MIC-TH_BD9.7-P2.50-D0.8-L-FD; Manufacturer Part KEAG4544PF-K; LCSC Part Name 全指向性麦克风,-44DB,3.0V
MIC_SELECT: XKB5858-Z-F-75; SW-SMD_XKB5858-Z-F-75; Voltage Rating 30V; Manufacturer Part XKB5858-Z-F-75; LCSC Part Name 轻操作力、低接触电阻按键开关
R4, R11: 0Ω; R0603
R5, R6, R8: 2.2kΩ; R0603; Manufacturer Part 0603WAF2201T5E; LCSC Part Name 2.2kΩ ±1% 100mW 厚膜电阻
R7: 100Ω; R0603; Manufacturer Part RC0603FR-07100RL; LCSC Part Name 厚膜电阻 100Ω ±1% 100mW
U1: AMS1117-1.8; SOT-223_L6.7-W3.5-P2.30-BR; Manufacturer Part AMS1117-1.8; LCSC Part Name 输出:1.8V 电流:1A 耐压:12V

Connections:
HEADPHONE_GROUND: CODEC.2 (HP_VGND), HEADPHONE.1
HEADPHONE_LEFT: CODEC.4 (HP_L), HEADPHONE.2
HEADPHONE_RIGHT: CODEC.1 (HP_R), HEADPHONE.5
I2C_SCL: CODEC.19 (CTRL_CLK), R5.2
I2C_SDA: CODEC.18 (CTRL_DATA), R6.2
I2S_BCLK: CODEC.15 (I2S_SCLK)
I2S_DIN: CODEC.17 (I2S_DIN)
I2S_DOUT: CODEC.16 (I2S_DOUT)
I2S_MLCK: R7.1
I2S_WS: CODEC.14 (I2S_LRCLK)
LINE_IN_LEFT: C25.1, LINE-IN.5
LINE_IN_RIGHT: C26.1, LINE-IN.2
LINE_OUT_LEFT: C27.1, LINE-OUT.5
LINE_OUT_RIGHT: C28.1, LINE-OUT.2
MIC_EXTERNAL: MIC_EXTERNAL.5, MIC_SELECT.4, MIC_SELECT.6
MIC_IN: C29.1, MIC_SELECT.1, MIC_SELECT.2, MIC_SELECT.5, R8.1
MIC_INTERNAL: MIC_INTERNAL.1, MIC_SELECT.3
unnamed: C14.1, C19.2, C20.2, C21.2, R11.1, U1.3 (VIN)
unnamed: C15.1, U1.2 (VOUT(TAB))
unnamed: C17.2, C18.2, CODEC.3 (VDDA), L1.2
unnamed: C22.2, CODEC.5 (VAG)
unnamed: C25.2, CODEC.9 (LINEIN_L)
unnamed: C26.2, CODEC.8 (LINEIN_R)
unnamed: C27.2, CODEC.7 (LINEOUT_L)
unnamed: C28.2, CODEC.6 (LINEOUT_R)
unnamed: C29.2, CODEC.10 (MIC)
unnamed: C30.2, CODEC.11 (MIC_BIAS), R8.2
unnamed: CODEC.12 (VDDIO), L1.1
unnamed: CODEC.13 (SYS_MCLK), R7.2
unnamed: R5.1, R6.1
