littleweirdo-studio/little-squeaky-machine-hardware/fabrication/v4/kicad_little_squeaky_machine/3_Led Controls.kicad_sch

## KiCad design fabrication/v4/kicad_little_squeaky_machine/3_Led Controls.kicad_sch (2026-11-06)

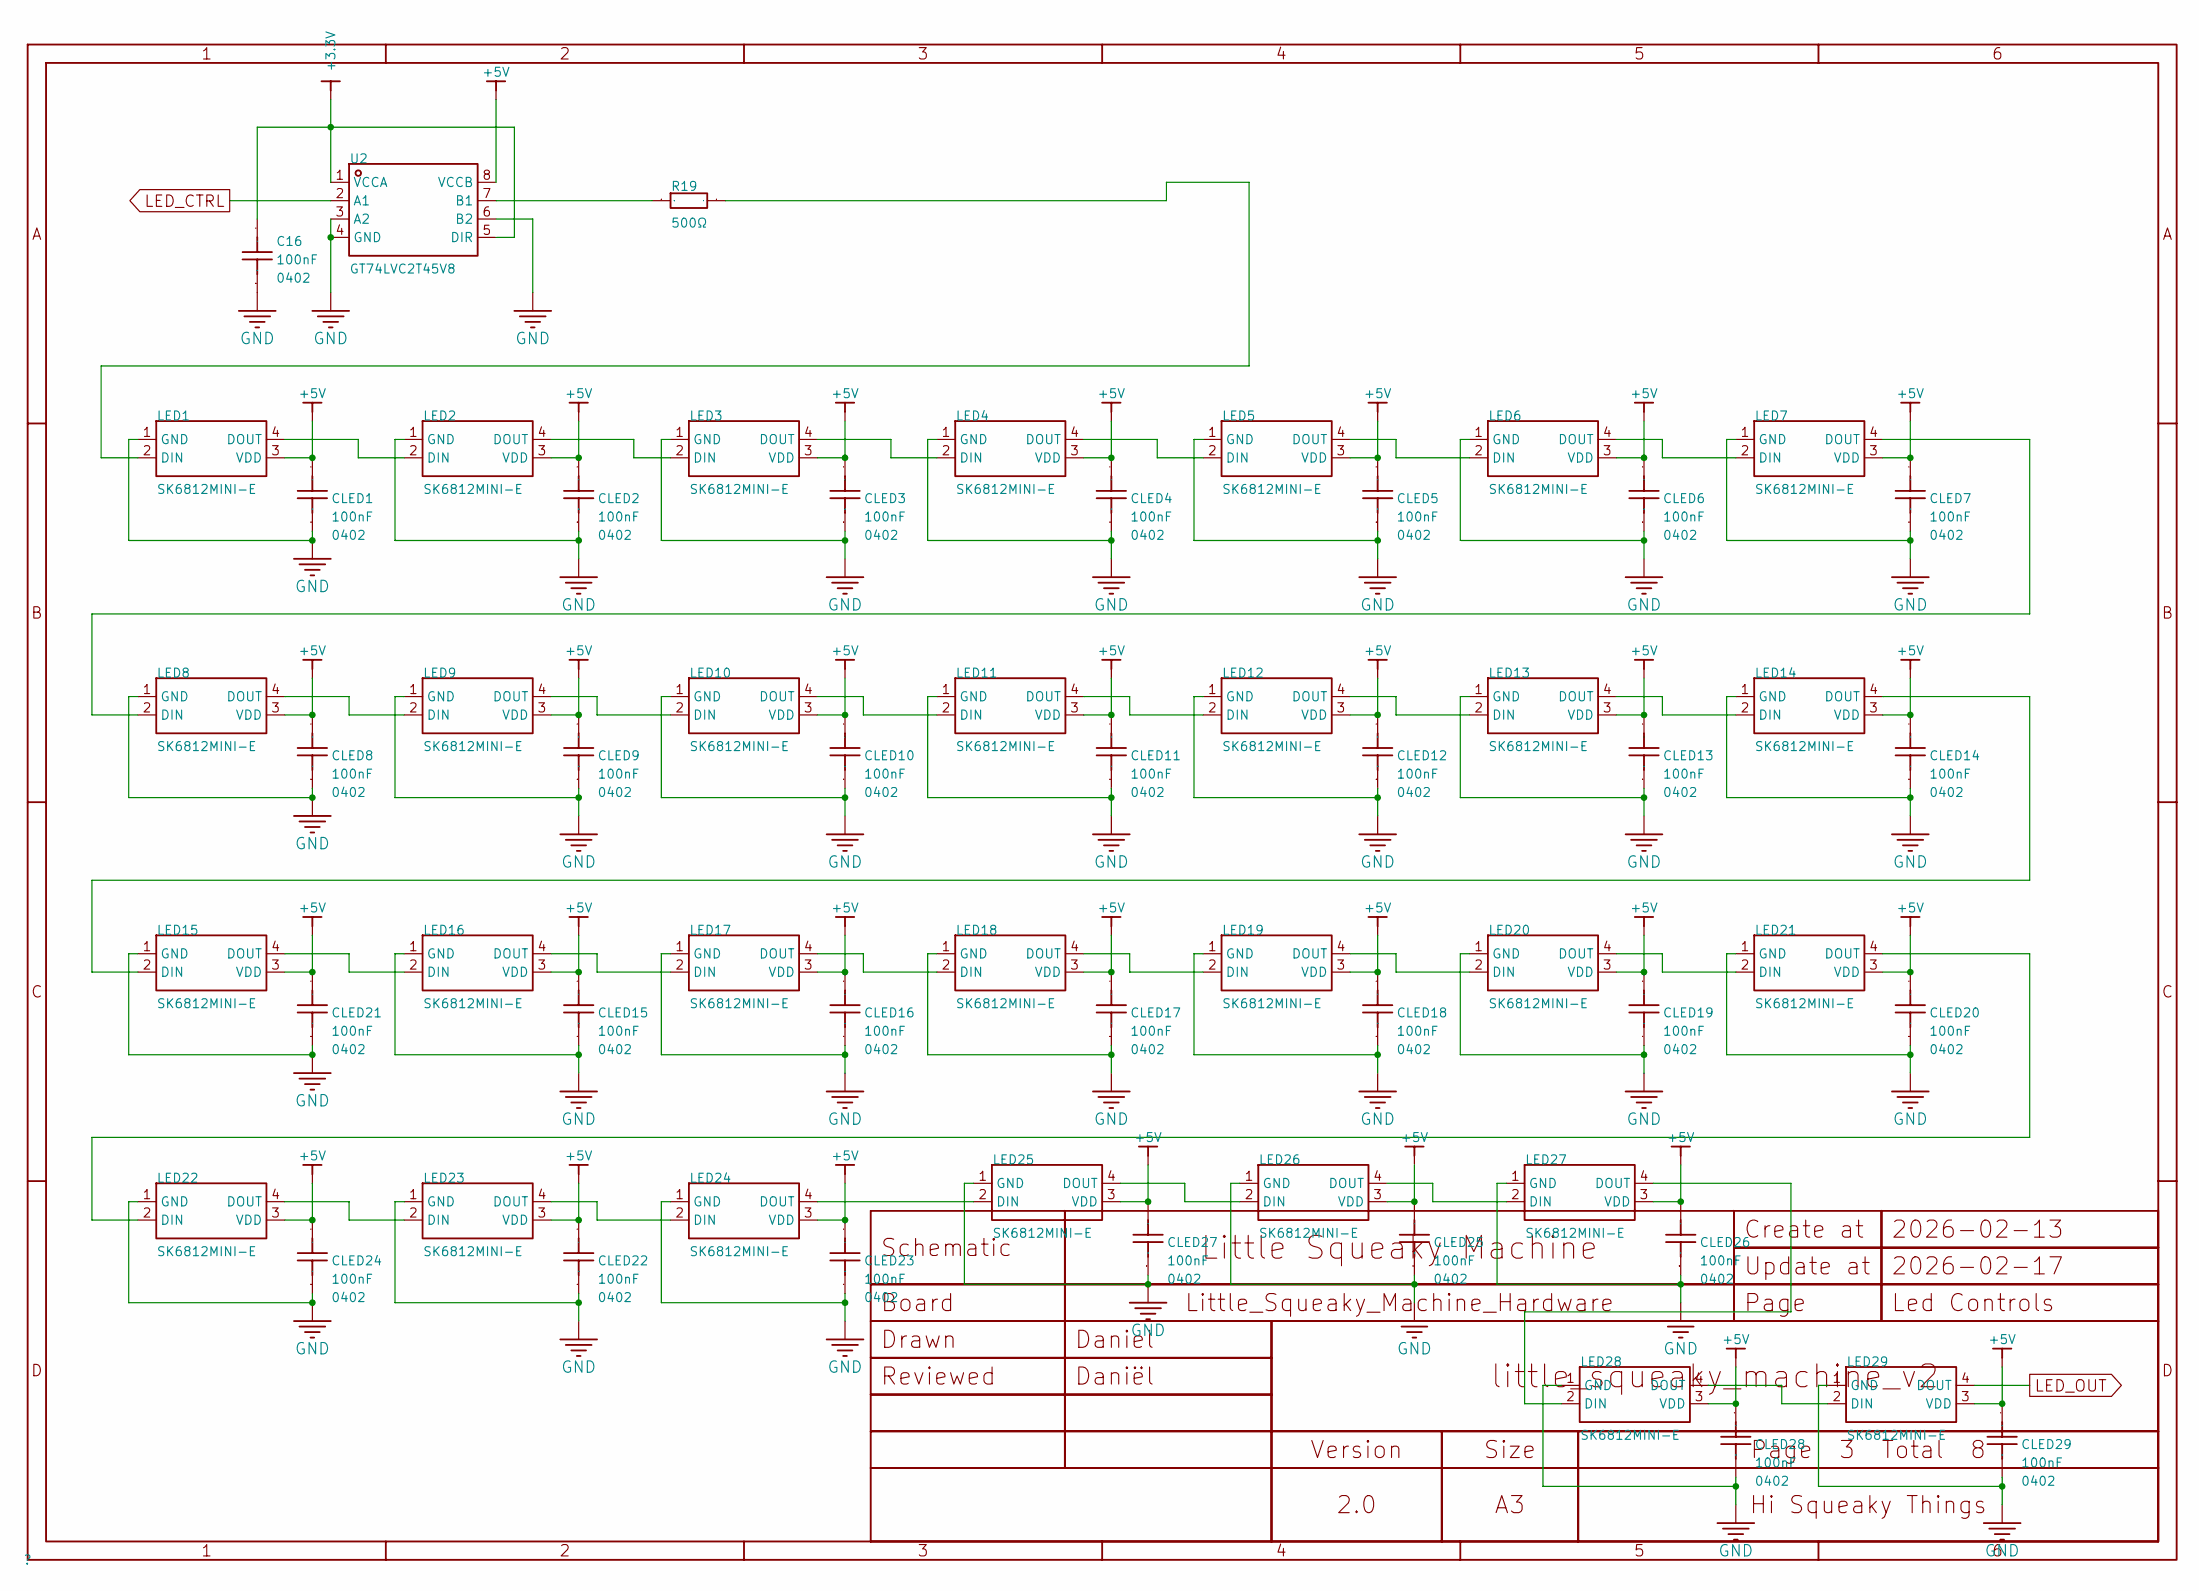
[picture p20: schematic 3_Led Controls.kicad_sch]

Parts:
C16: 100nF; C0402; Voltage Rating 16V; Manufacturer Part CL05B104KO5NNNC; LCSC Part Name 100nF ±10% 16V
CLED1, CLED2, CLED3, CLED4, CLED5, CLED6, CLED7, CLED8, CLED9, CLED10, CLED11, CLED12, CLED13, CLED14, CLED15, CLED16, CLED17, CLED18, CLED19, CLED20, CLED21, CLED22, CLED23, CLED24, CLED25, CLED26, CLED27, CLED28, CLED29: 100nF; C0402; Voltage Rating 16V; Manufacturer Part CL05B104KO5NNNC; LCSC Part Name 100nF ±10% 16V
LED1, LED2, LED3, LED4, LED5, LED6, LED7, LED8, LED9, LED10, LED11, LED12, LED13, LED14, LED15, LED16, LED17, LED18, LED19, LED20, LED21, LED22, LED23, LED24, LED25, LED26, LED27, LED28, LED29: SK6812MINI-E; LED-SMD_4P-L3.2-W2.8-LS5.9_SK6812MINI-E; Voltage - Supply 3.7V~5.5V; Manufacturer Part SK6812MINI-E; LCSC Part Name 工作电压5V、发光角度120°、灰度调节256级的RGB LED
R19: 500Ω; R0603; Manufacturer Part RT0603BRD07500RL; LCSC Part Name 薄膜电阻 500Ω ±0.1% 100mW
U2: GT74LVC2T45V8; VSSOP-8_L2.3-W2.0-P0.50-LS3.1-BL; Manufacturer Part GT74LVC2T45V8; LCSC Part Name GT74LVC2T45V8

Connections:
LED_CTRL: U2.2 (A1)
LED_OUT: LED29.4 (DOUT)
unnamed: C16.2, U2.1 (VCCA), U2.5 (DIR)
unnamed: CLED1.1, LED1.1 (GND)
unnamed: CLED1.2, LED1.3 (VDD)
unnamed: CLED2.1, LED2.1 (GND)
unnamed: CLED2.2, LED2.3 (VDD)
unnamed: CLED3.1, LED3.1 (GND)
unnamed: CLED3.2, LED3.3 (VDD)
unnamed: CLED4.1, LED4.1 (GND)
unnamed: CLED4.2, LED4.3 (VDD)
unnamed: CLED5.1, LED5.1 (GND)
unnamed: CLED5.2, LED5.3 (VDD)
unnamed: CLED6.1, LED6.1 (GND)
unnamed: CLED6.2, LED6.3 (VDD)
unnamed: CLED7.1, LED7.1 (GND)
unnamed: CLED7.2, LED7.3 (VDD)
unnamed: CLED8.1, LED8.1 (GND)
unnamed: CLED8.2, LED8.3 (VDD)
unnamed: CLED9.1, LED9.1 (GND)
unnamed: CLED9.2, LED9.3 (VDD)
unnamed: CLED10.1, LED10.1 (GND)
unnamed: CLED10.2, LED10.3 (VDD)
unnamed: CLED11.1, LED11.1 (GND)
unnamed: CLED11.2, LED11.3 (VDD)
unnamed: CLED12.1, LED12.1 (GND)
unnamed: CLED12.2, LED12.3 (VDD)
unnamed: CLED13.1, LED13.1 (GND)
unnamed: CLED13.2, LED13.3 (VDD)
unnamed: CLED14.1, LED14.1 (GND)
unnamed: CLED14.2, LED14.3 (VDD)
unnamed: CLED15.1, LED16.1 (GND)
unnamed: CLED15.2, LED16.3 (VDD)
unnamed: CLED16.1, LED17.1 (GND)
unnamed: CLED16.2, LED17.3 (VDD)
unnamed: CLED17.1, LED18.1 (GND)
unnamed: CLED17.2, LED18.3 (VDD)
unnamed: CLED18.1, LED19.1 (GND)
unnamed: CLED18.2, LED19.3 (VDD)
unnamed: CLED19.1, LED20.1 (GND)
unnamed: CLED19.2, LED20.3 (VDD)
unnamed: CLED20.1, LED21.1 (GND)
unnamed: CLED20.2, LED21.3 (VDD)
unnamed: CLED21.1, LED15.1 (GND)
unnamed: CLED21.2, LED15.3 (VDD)
unnamed: CLED22.1, LED23.1 (GND)
unnamed: CLED22.2, LED23.3 (VDD)
unnamed: CLED23.1, LED24.1 (GND)
unnamed: CLED23.2, LED24.3 (VDD)
unnamed: CLED24.1, LED22.1 (GND)
unnamed: CLED24.2, LED22.3 (VDD)
unnamed: CLED25.1, LED26.1 (GND)
unnamed: CLED25.2, LED26.3 (VDD)
unnamed: CLED26.1, LED27.1 (GND)
unnamed: CLED26.2, LED27.3 (VDD)
unnamed: CLED27.1, LED25.1 (GND)
unnamed: CLED27.2, LED25.3 (VDD)
unnamed: CLED28.1, LED28.1 (GND)
unnamed: CLED28.2, LED28.3 (VDD)
unnamed: CLED29.1, LED29.1 (GND)
unnamed: CLED29.2, LED29.3 (VDD)
unnamed: LED1.2 (DIN), R19.2
unnamed: LED1.4 (DOUT), LED2.2 (DIN)
unnamed: LED2.4 (DOUT), LED3.2 (DIN)
unnamed: LED3.4 (DOUT), LED4.2 (DIN)
unnamed: LED4.4 (DOUT), LED5.2 (DIN)
unnamed: LED5.4 (DOUT), LED6.2 (DIN)
unnamed: LED6.4 (DOUT), LED7.2 (DIN)
unnamed: LED7.4 (DOUT), LED8.2 (DIN)
unnamed: LED8.4 (DOUT), LED9.2 (DIN)
unnamed: LED9.4 (DOUT), LED10.2 (DIN)
unnamed: LED10.4 (DOUT), LED11.2 (DIN)
unnamed: LED11.4 (DOUT), LED12.2 (DIN)
unnamed: LED12.4 (DOUT), LED13.2 (DIN)
unnamed: LED13.4 (DOUT), LED14.2 (DIN)
unnamed: LED14.4 (DOUT), LED15.2 (DIN)
unnamed: LED15.4 (DOUT), LED16.2 (DIN)
unnamed: LED16.4 (DOUT), LED17.2 (DIN)
unnamed: LED17.4 (DOUT), LED18.2 (DIN)
unnamed: LED18.4 (DOUT), LED19.2 (DIN)
unnamed: LED19.4 (DOUT), LED20.2 (DIN)
unnamed: LED20.4 (DOUT), LED21.2 (DIN)
unnamed: LED21.4 (DOUT), LED22.2 (DIN)
unnamed: LED22.4 (DOUT), LED23.2 (DIN)
unnamed: LED23.4 (DOUT), LED24.2 (DIN)
unnamed: LED24.4 (DOUT), LED25.2 (DIN)
unnamed: LED25.4 (DOUT), LED26.2 (DIN)
unnamed: LED26.4 (DOUT), LED27.2 (DIN)
unnamed: LED27.4 (DOUT), LED28.2 (DIN)
unnamed: LED28.4 (DOUT), LED29.2 (DIN)
unnamed: R19.1, U2.7 (B1)
unnamed: U2.3 (A2), U2.4 (GND)
