littleweirdo-studio/little-squeaky-machine-hardware/fabrication/v4/kicad_little_squeaky_machine/4_Key Matrix Controls.kicad_sch

## KiCad design fabrication/v4/kicad_little_squeaky_machine/4_Key Matrix Controls.kicad_sch (2026-11-06)

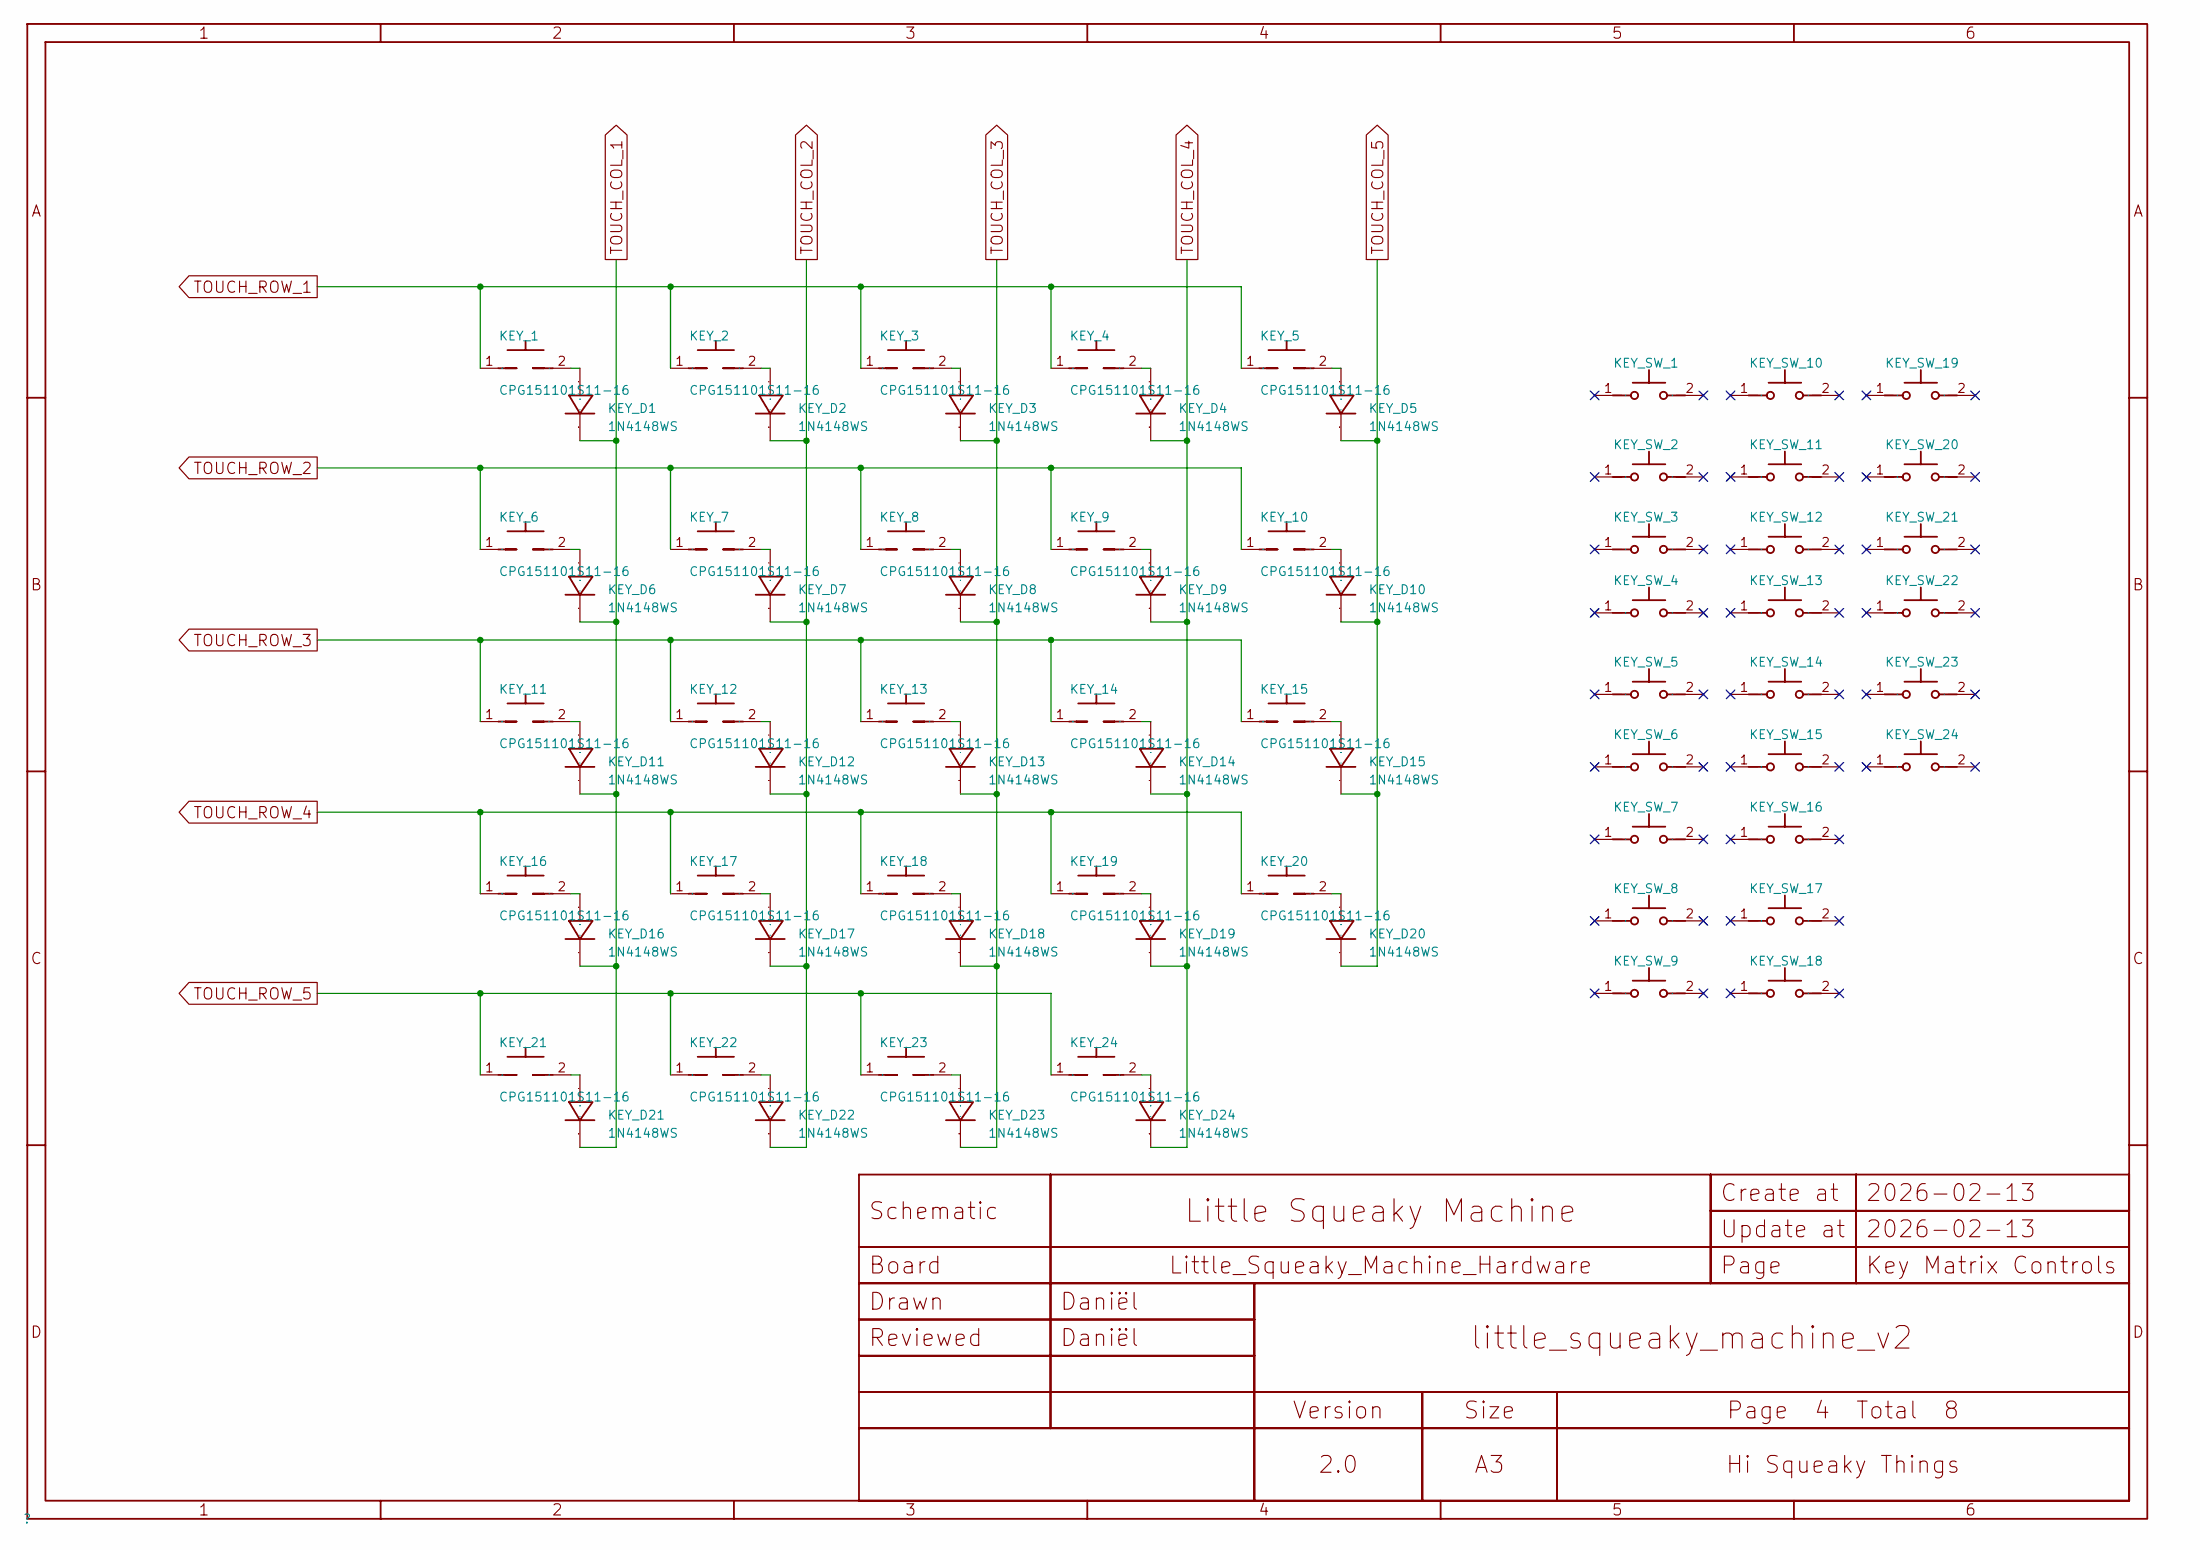
[picture p21: schematic 4_Key Matrix Controls.kicad_sch]

Parts:
KEY_1, KEY_2, KEY_3, KEY_4, KEY_5, KEY_6, KEY_7, KEY_8, KEY_9, KEY_10, KEY_11, KEY_12, KEY_13, KEY_14, KEY_15, KEY_16, KEY_17, KEY_18, KEY_19, KEY_20, KEY_21, KEY_22, KEY_23, KEY_24: CPG151101S11-16; SMD_KEYBOARD-SW; Voltage Rating 12V; Manufacturer Part CPG151101S11-16; LCSC Part Name 热插拔底座连接器 键盘配件
KEY_D1, KEY_D2, KEY_D3, KEY_D4, KEY_D5, KEY_D6, KEY_D7, KEY_D8, KEY_D9, KEY_D10, KEY_D11, KEY_D12, KEY_D13, KEY_D14, KEY_D15, KEY_D16, KEY_D17, KEY_D18, KEY_D19, KEY_D20, KEY_D21, KEY_D22, KEY_D23, KEY_D24: 1N4148WS; SOD-323_L1.8-W1.3-LS2.5-RD; Voltage - DC Reverse(Vr) 75V; Voltage - Forward(Vf@If) 1.25V@150mA; Manufacturer Part 1N4148WS; LCSC Part Name 75V 150mA
KEY_SW_1, KEY_SW_2, KEY_SW_3, KEY_SW_4, KEY_SW_5, KEY_SW_6, KEY_SW_7, KEY_SW_8, KEY_SW_9, KEY_SW_10, KEY_SW_11, KEY_SW_12, KEY_SW_13, KEY_SW_14, KEY_SW_15, KEY_SW_16, KEY_SW_17, KEY_SW_18, KEY_SW_19, KEY_SW_20, KEY_SW_21, KEY_SW_22, KEY_SW_23, KEY_SW_24: CPG1511F01S04; KEY-TH_CPG1511F01S0X; Operating Voltage 2V~12V; Manufacturer Part CPG1511F01S04; LCSC Part Name BOX 红轴

Connections:
unnamed: KEY_1.2, KEY_D1.2 (A)
unnamed: KEY_2.2, KEY_D2.2 (A)
unnamed: KEY_3.2, KEY_D3.2 (A)
unnamed: KEY_4.2, KEY_D4.2 (A)
unnamed: KEY_5.2, KEY_D5.2 (A)
unnamed: KEY_6.2, KEY_D6.2 (A)
unnamed: KEY_7.2, KEY_D7.2 (A)
unnamed: KEY_8.2, KEY_D8.2 (A)
unnamed: KEY_9.2, KEY_D9.2 (A)
unnamed: KEY_10.2, KEY_D10.2 (A)
unnamed: KEY_11.2, KEY_D11.2 (A)
unnamed: KEY_12.2, KEY_D12.2 (A)
unnamed: KEY_13.2, KEY_D13.2 (A)
unnamed: KEY_14.2, KEY_D14.2 (A)
unnamed: KEY_15.2, KEY_D15.2 (A)
unnamed: KEY_16.2, KEY_D16.2 (A)
unnamed: KEY_17.2, KEY_D17.2 (A)
unnamed: KEY_18.2, KEY_D18.2 (A)
unnamed: KEY_19.2, KEY_D19.2 (A)
unnamed: KEY_20.2, KEY_D20.2 (A)
unnamed: KEY_21.2, KEY_D21.2 (A)
unnamed: KEY_22.2, KEY_D22.2 (A)
unnamed: KEY_23.2, KEY_D23.2 (A)
unnamed: KEY_24.2, KEY_D24.2 (A)
TOUCH_COL_1: KEY_D1.1 (C), KEY_D6.1 (C), KEY_D11.1 (C), KEY_D16.1 (C), KEY_D21.1 (C)
TOUCH_COL_2: KEY_D2.1 (C), KEY_D7.1 (C), KEY_D12.1 (C), KEY_D17.1 (C), KEY_D22.1 (C)
TOUCH_COL_3: KEY_D3.1 (C), KEY_D8.1 (C), KEY_D13.1 (C), KEY_D18.1 (C), KEY_D23.1 (C)
TOUCH_COL_4: KEY_D4.1 (C), KEY_D9.1 (C), KEY_D14.1 (C), KEY_D19.1 (C), KEY_D24.1 (C)
TOUCH_COL_5: KEY_D5.1 (C), KEY_D10.1 (C), KEY_D15.1 (C), KEY_D20.1 (C)
TOUCH_ROW_1: KEY_1.1, KEY_2.1, KEY_3.1, KEY_4.1, KEY_5.1
TOUCH_ROW_2: KEY_6.1, KEY_7.1, KEY_8.1, KEY_9.1, KEY_10.1
TOUCH_ROW_3: KEY_11.1, KEY_12.1, KEY_13.1, KEY_14.1, KEY_15.1
TOUCH_ROW_4: KEY_16.1, KEY_17.1, KEY_18.1, KEY_19.1, KEY_20.1
TOUCH_ROW_5: KEY_21.1, KEY_22.1, KEY_23.1, KEY_24.1
