littleweirdo-studio/little-squeaky-machine-hardware/fabrication/v4/kicad_little_squeaky_machine/5_Pot and Encoder Controls.kicad_sch

## KiCad design fabrication/v4/kicad_little_squeaky_machine/5_Pot and Encoder Controls.kicad_sch (2026-11-06)

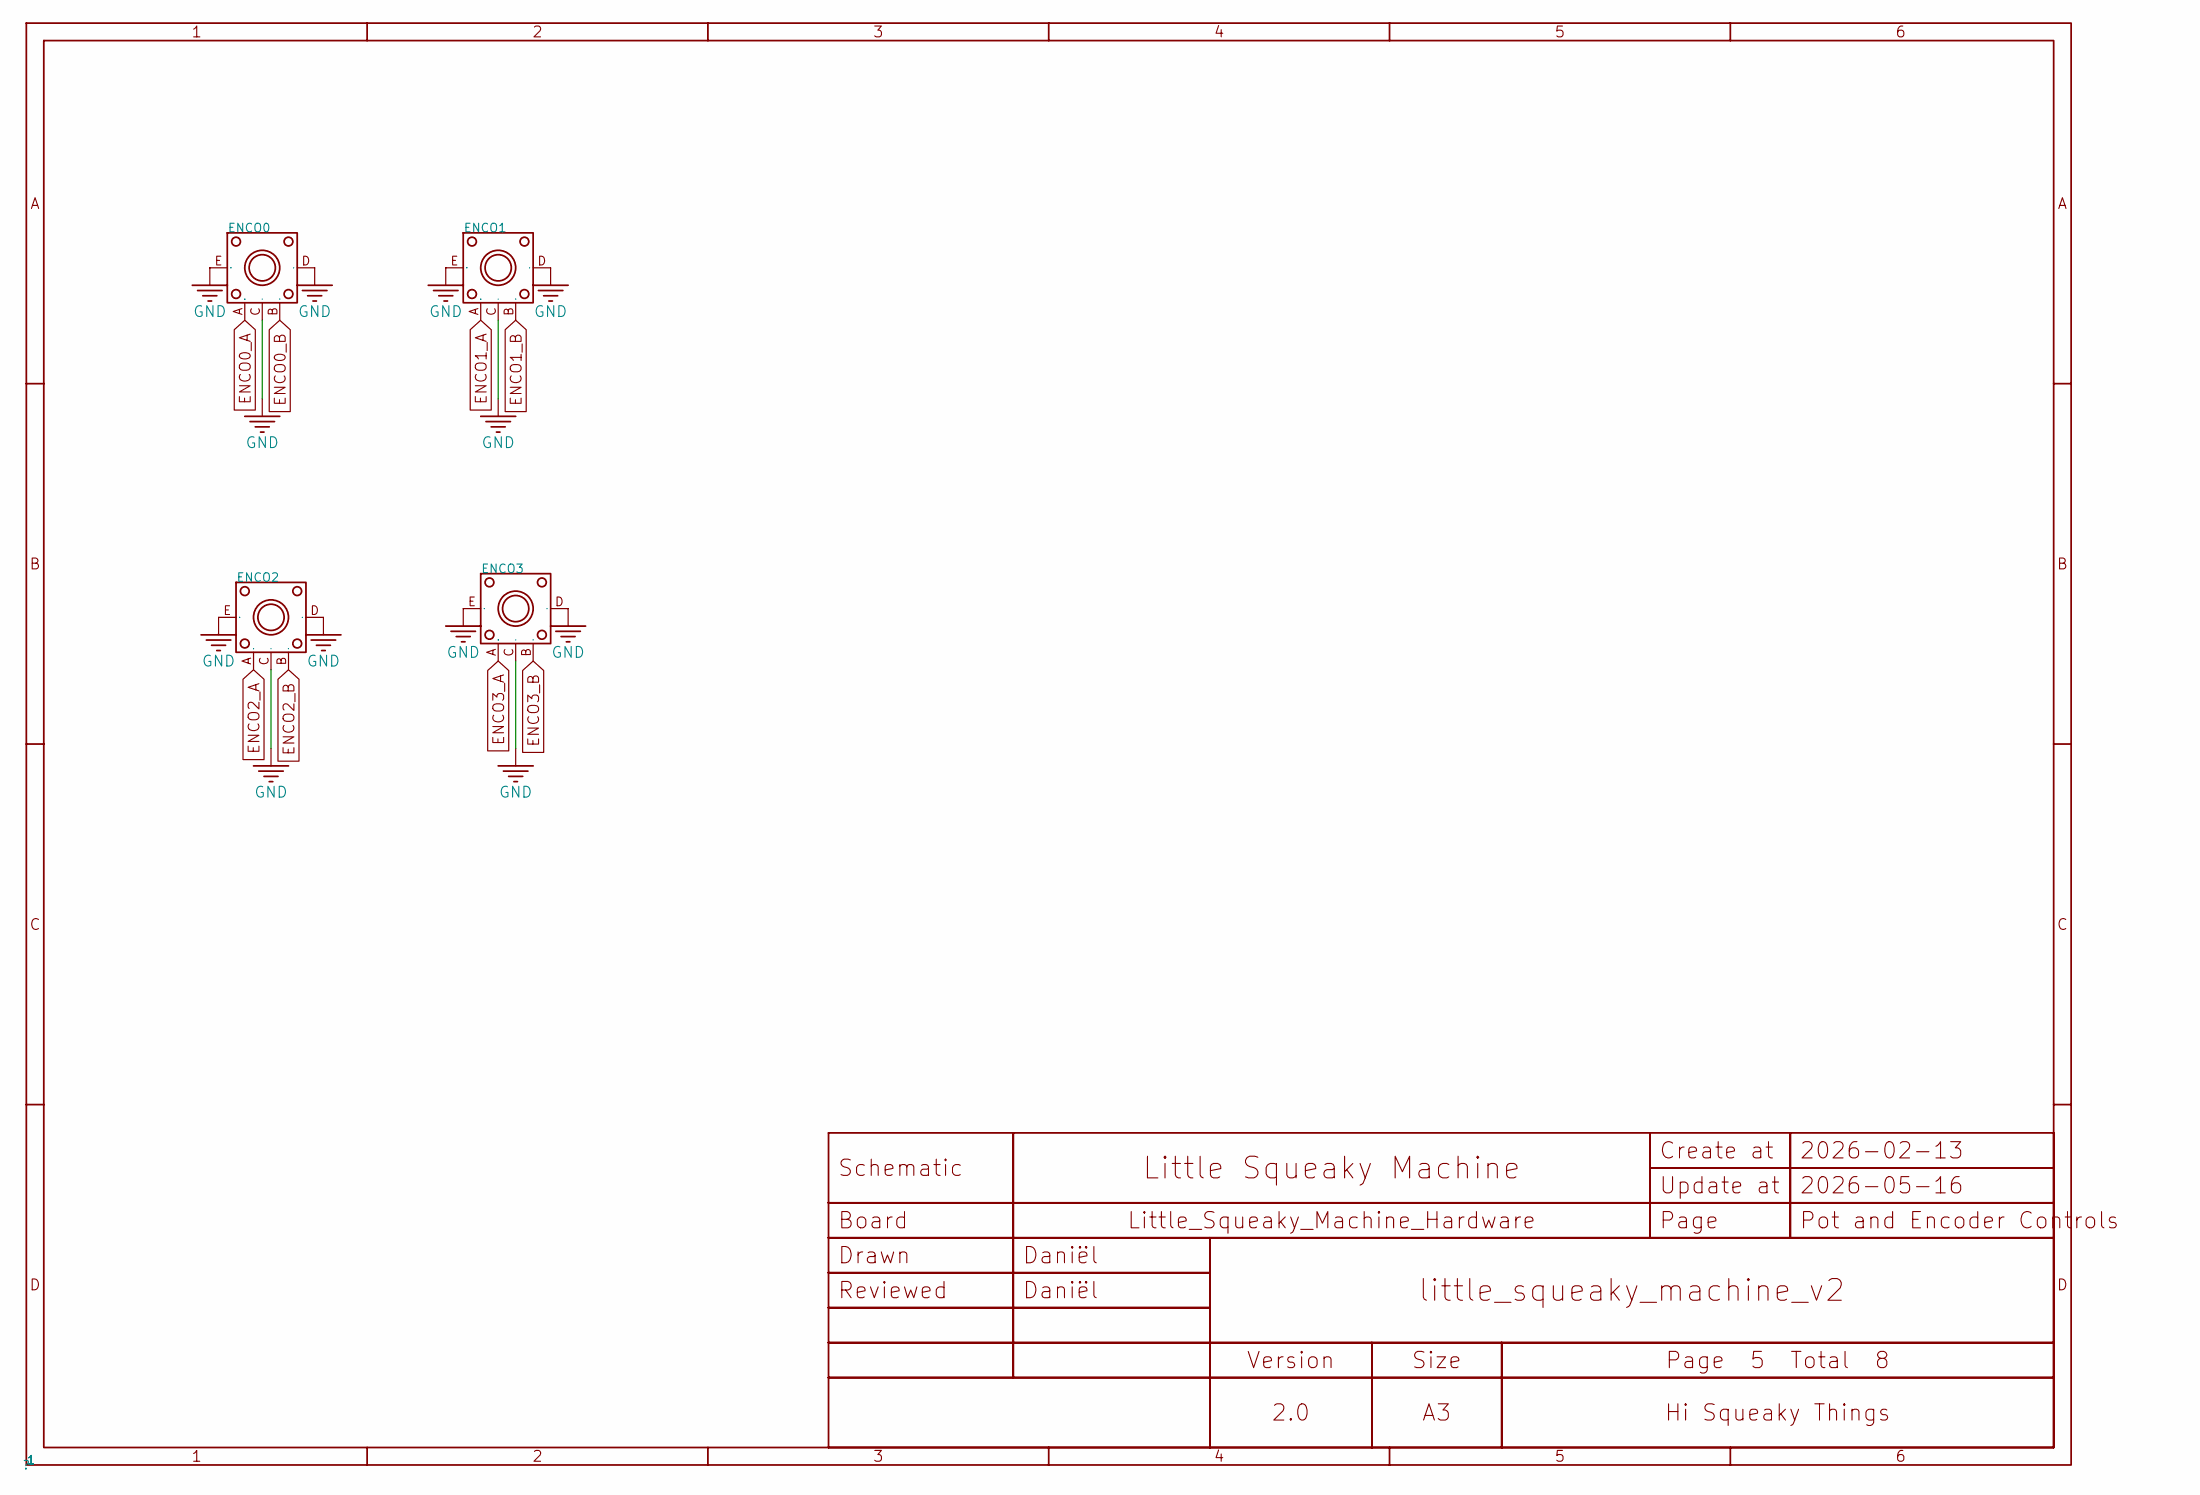
[picture p22: schematic 5_Pot and Encoder Controls.kicad_sch]

Parts:
ENCO0, ENCO1, ENCO2, ENCO3: EC12E24404A8; SW-TH_EC12EXXXX; Manufacturer Part EC12E24404A8; LCSC Part Name 12型绝缘轴型编码器

Connections:
ENCO0_A: ENCO0.A
ENCO0_B: ENCO0.B
ENCO1_A: ENCO1.A
ENCO1_B: ENCO1.B
ENCO2_A: ENCO2.A
ENCO2_B: ENCO2.B
ENCO3_A: ENCO3.A
ENCO3_B: ENCO3.B
