littleweirdo-studio/little-squeaky-machine-hardware/fabrication/v4/kicad_little_squeaky_machine/6_Midi In{slash}Out.kicad_sch

## KiCad design fabrication/v4/kicad_little_squeaky_machine/6_Midi In{slash}Out.kicad_sch (2026-11-06)

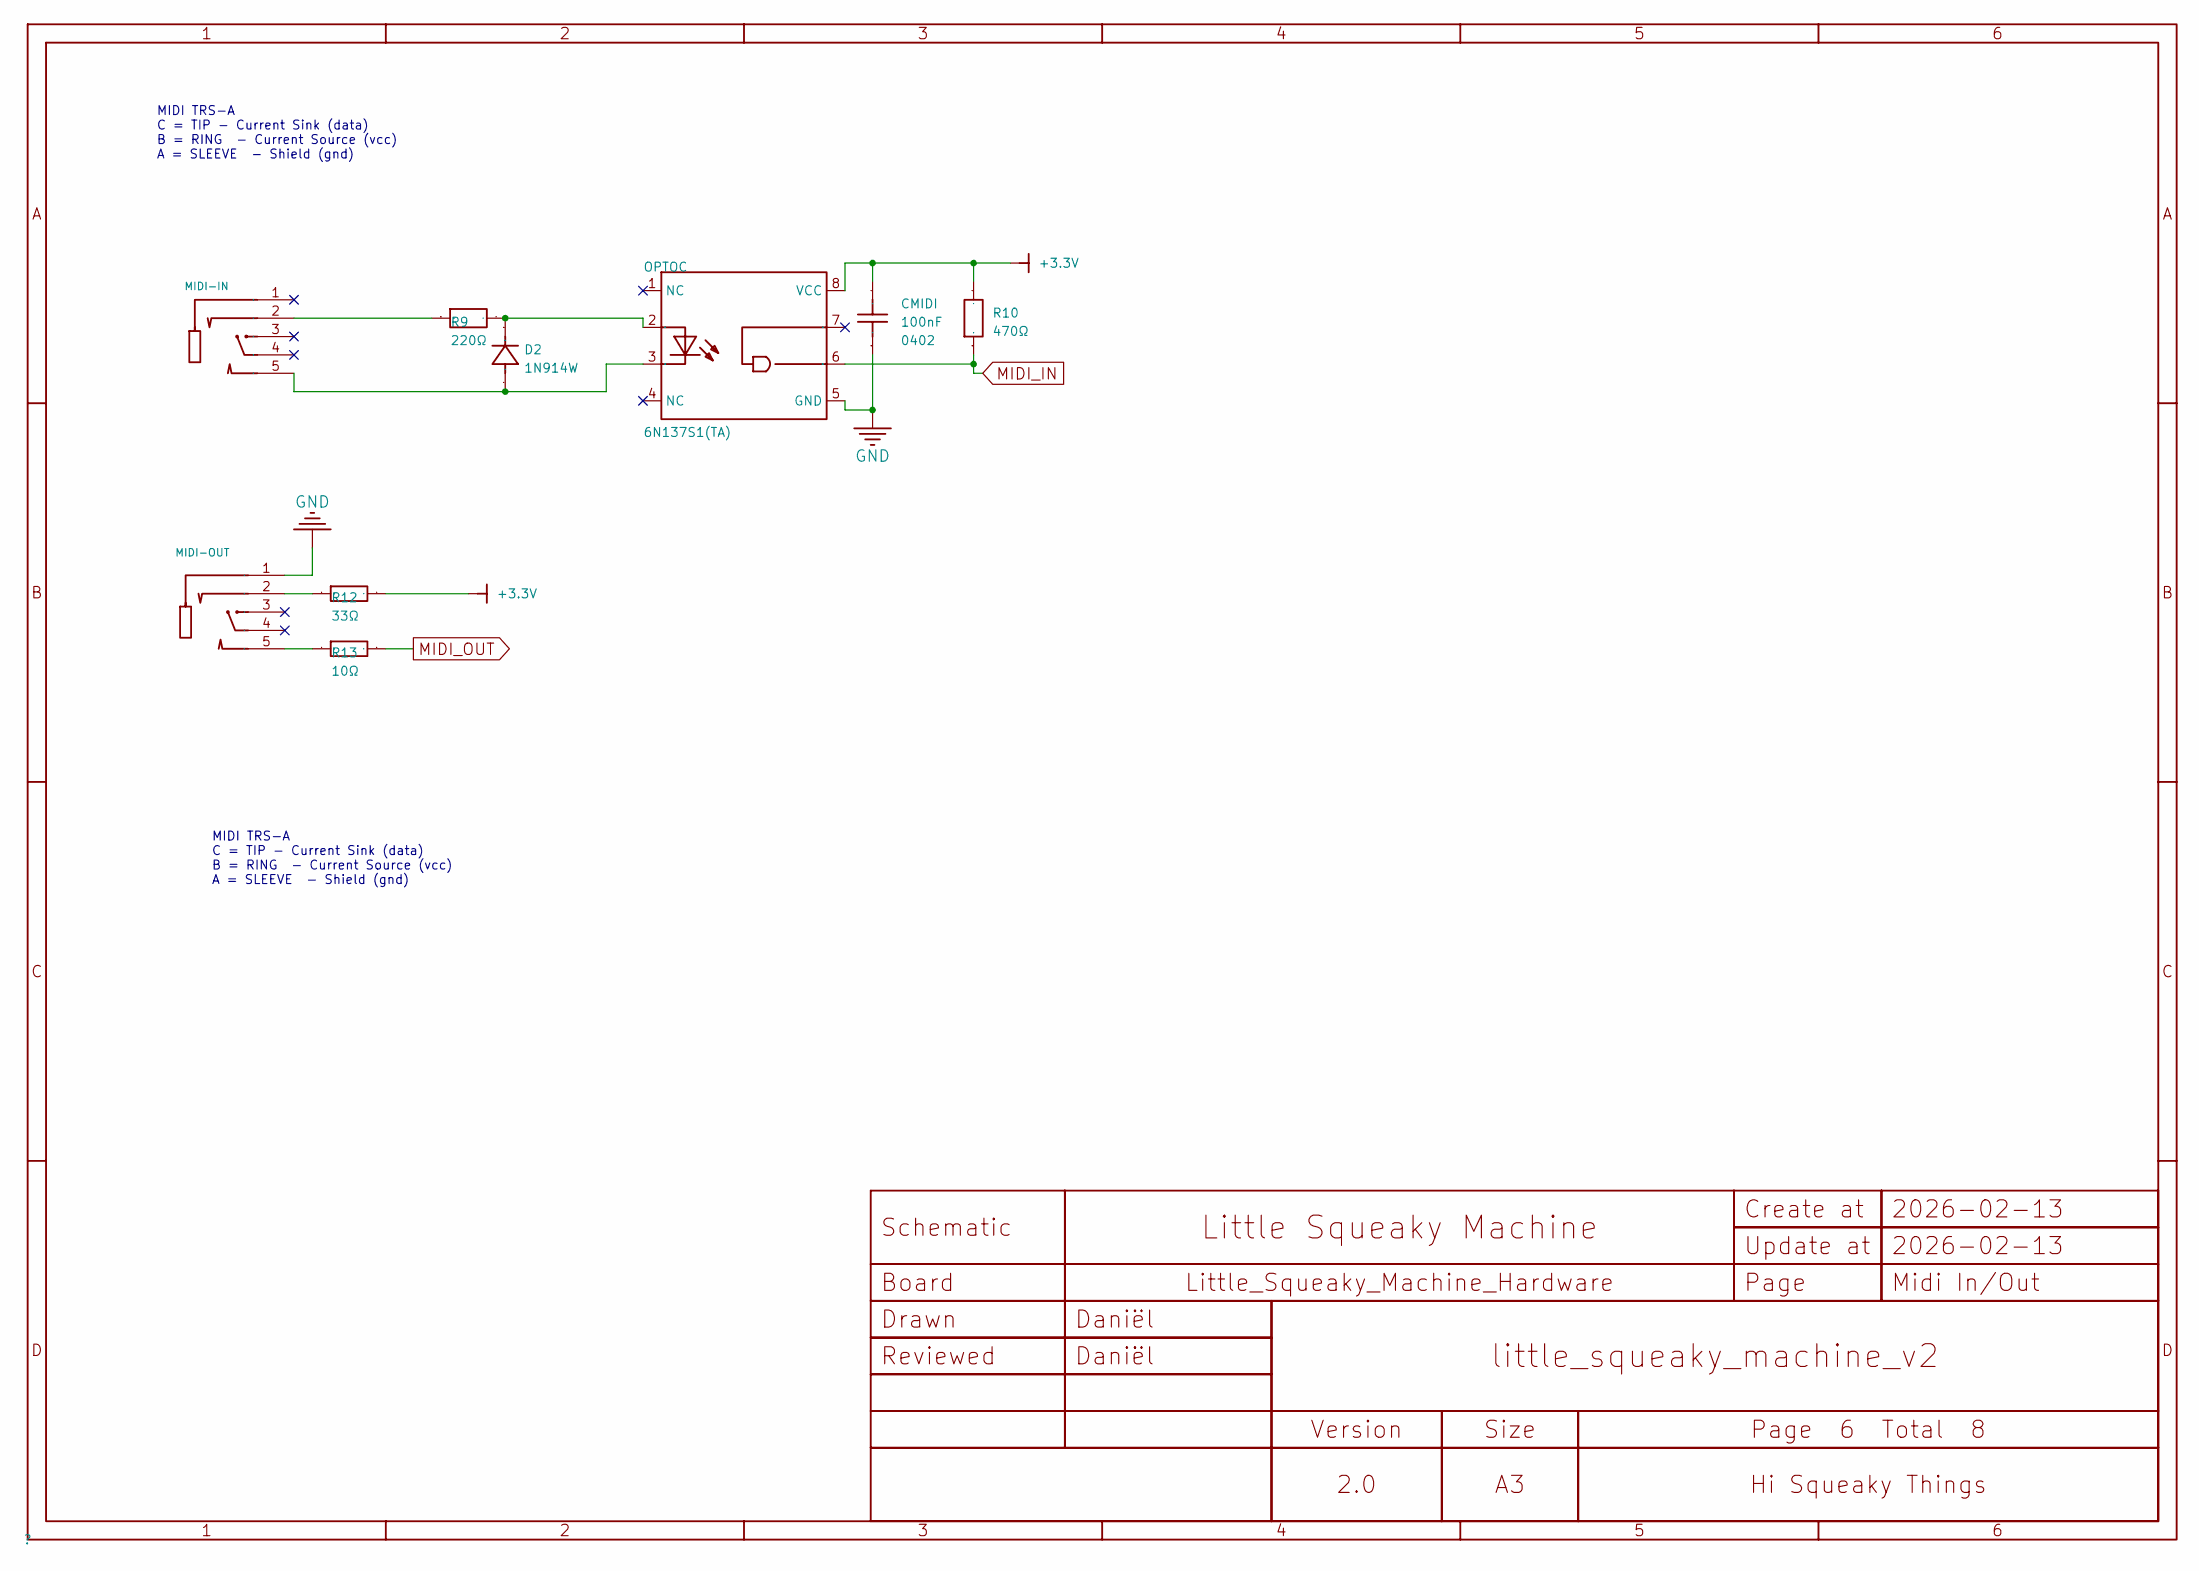
[picture p23: schematic 6_Midi In{slash}Out.kicad_sch]

Parts:
CMIDI: 100nF; C0402; Voltage Rating 16V; Manufacturer Part CL05B104KO5NNNC; LCSC Part Name 100nF ±10% 16V
D2: 1N914W; SOD-123_L2.7-W1.6-LS3.7-RD-1; Manufacturer Part 1N914W; LCSC Part Name T4(T4表示丝印)
MIDI-IN: PJ-3062-HD-B; AUDIO-TH_PJ-3062-HD-B; Current Rating 500mA; Manufacturer Part PJ-3062-HD-B; LCSC Part Name 黑色 3.5mm耳机座
MIDI-OUT: PJ-3062-HD-B; AUDIO-TH_PJ-3062-HD-B; Current Rating 500mA; Manufacturer Part PJ-3062-HD-B; LCSC Part Name 黑色 3.5mm耳机座
OPTOC: 6N137S1(TA); SMD-8_L9.8-W6.6-P2.54-LS10.3-BL; Manufacturer Part 6N137S1(TA); LCSC Part Name DC输入 1通道 隔离电压(rms):5000V
R9: 220Ω; R0603; Manufacturer Part SCR0603J220R; LCSC Part Name 厚膜电阻 220Ω ±5% 100mW
R10: 470Ω; R0603; Manufacturer Part SCR0603F470R; LCSC Part Name 厚膜电阻 470Ω ±1% 100mW
R12: 33Ω; R0603; Manufacturer Part 0603WAF330JT5E; LCSC Part Name 33Ω ±1% 100mW 厚膜电阻
R13: 10Ω; R0603; Manufacturer Part QR0603J10R0P05Z; LCSC Part Name 厚膜电阻 10Ω ±5% 100mW

Connections:
MIDI_IN: OPTOC.6 (VOUT), R10.1
MIDI_OUT: R13.2
unnamed: CMIDI.1, OPTOC.5 (GND)
unnamed: CMIDI.2, OPTOC.8 (VCC), R10.2
unnamed: D2.1 (K), OPTOC.2 (AN), R9.2
unnamed: D2.2 (A), MIDI-IN.5, OPTOC.3 (CAT)
unnamed: MIDI-IN.2, R9.1
unnamed: MIDI-OUT.2, R12.1
unnamed: MIDI-OUT.5, R13.1

Notes on the sheet:
MIDI TRS-A C = TIP - Current Sink (data) B = RING - Current Source (vcc) A = SLEEVE - Shield (gnd)
