littleweirdo-studio/little-squeaky-machine-hardware/fabrication/v4/kicad_little_squeaky_machine/7_Touch control.kicad_sch

## KiCad design fabrication/v4/kicad_little_squeaky_machine/7_Touch control.kicad_sch (2026-11-06)

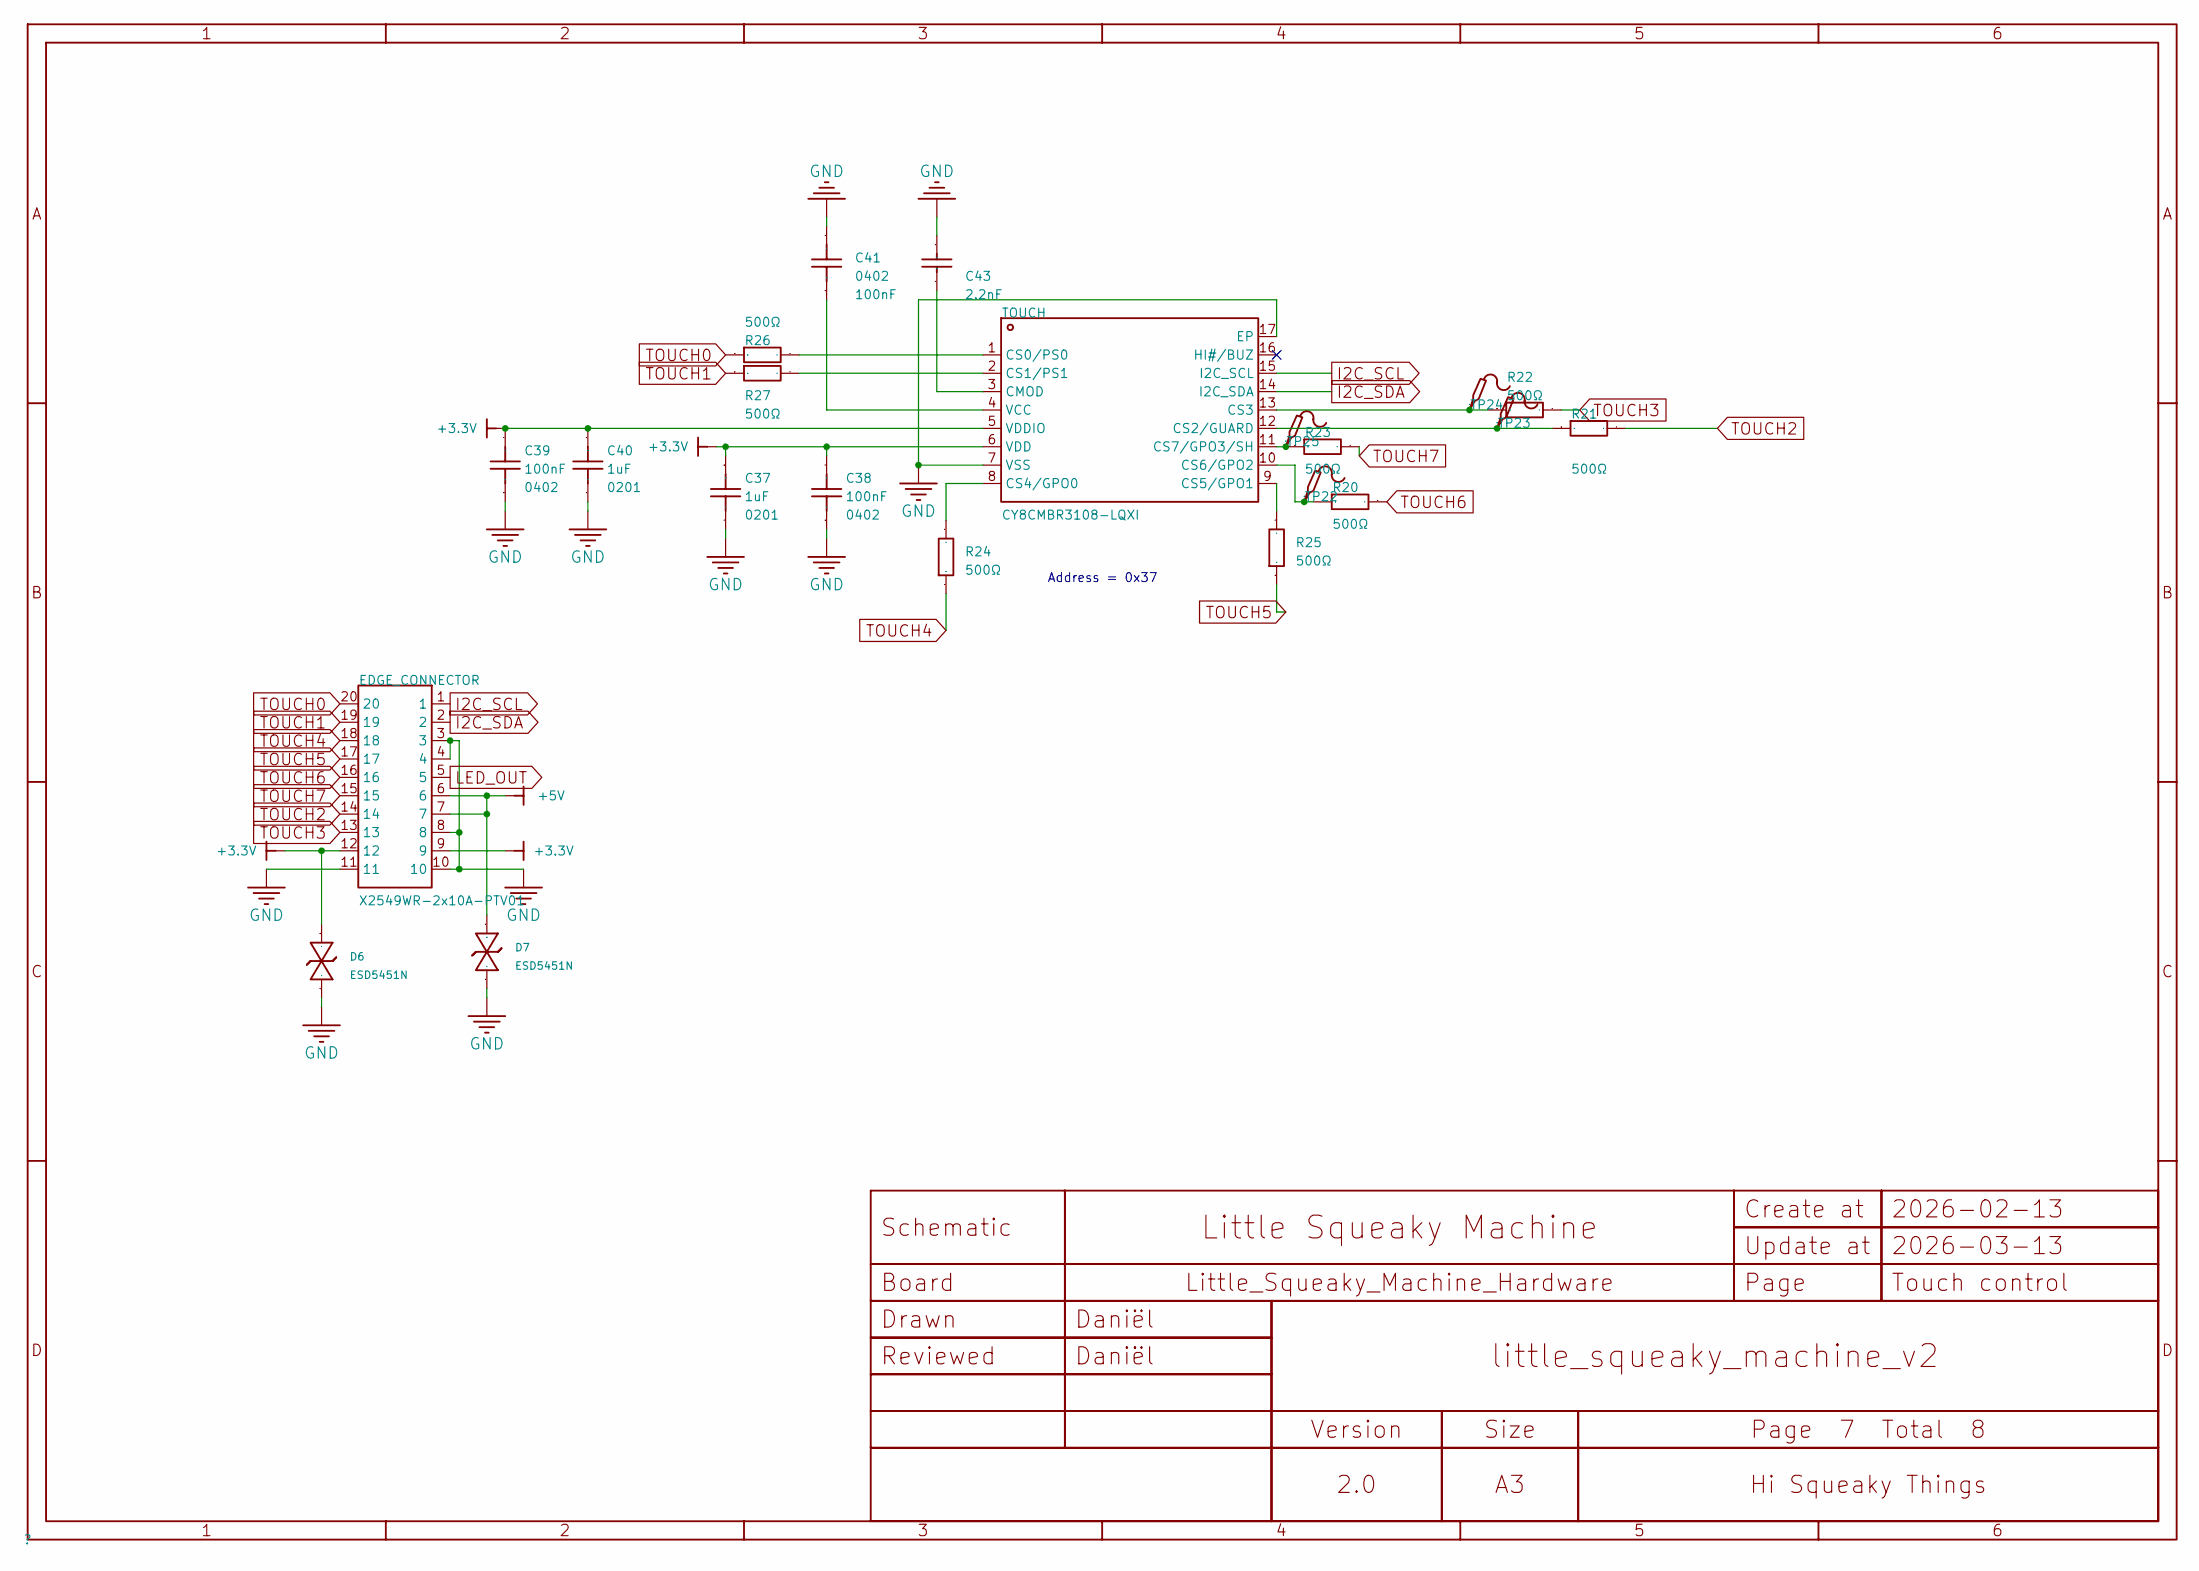
[picture p24: schematic 7_Touch control.kicad_sch]

Parts:
C37, C40: 1uF; C0603; Manufacturer Part GRM033R61A105ME44D; LCSC Part Name 1uF ±20% 10V
C38, C39, C41: 100nF; C0402; Voltage Rating 16V; Manufacturer Part CL05B104KO5NNNC; LCSC Part Name 100nF ±10% 16V
C43: 2.2nF; C0805; Manufacturer Part CL21C222JBFNNNE; LCSC Part Name 2.2nF(222) ±5% 50V
D6, D7: ESD5451N; DFN1006-2L-BI; Clamping Voltage 11V; Voltage - Breakdown 5.6V; Manufacturer Part ESD5451N; LCSC Part Name ESD5451N
EDGE_CONNECTOR: X2549WR-2x10A-PTV01; Manufacturer Part X2549WR-2x10A-PTV01; LCSC Part Name 2.54mm P数:20P
R20, R21, R22, R23, R24, R25, R26, R27: 500Ω; R0603; Manufacturer Part RT0603BRD07500RL; LCSC Part Name 薄膜电阻 500Ω ±0.1% 100mW
TOUCH: CY8CMBR3108-LQXI; QFN-16_L3.0-W3.0-P0.50-BL-EP1.7; Manufacturer Part CY8CMBR3108-LQXI; LCSC Part Name Capacitive Touch Buttons
TP22, TP23, TP24, TP25: Test-Point-0.5mm

Connections:
I2C_SCL: EDGE_CONNECTOR.1, TOUCH.15 (I2C_SCL)
I2C_SDA: EDGE_CONNECTOR.2, TOUCH.14 (I2C_SDA)
LED_OUT: EDGE_CONNECTOR.5
unnamed: C37.1, C38.2, TOUCH.6 (VDD)
unnamed: C39.2, C40.1, TOUCH.5 (VDDIO)
unnamed: C41.1, TOUCH.4 (VCC)
unnamed: C43.1, TOUCH.3 (CMOD)
unnamed: D6.1, EDGE_CONNECTOR.12
unnamed: D7.1, EDGE_CONNECTOR.6, EDGE_CONNECTOR.7
unnamed: EDGE_CONNECTOR.3, EDGE_CONNECTOR.4, EDGE_CONNECTOR.8, EDGE_CONNECTOR.10
unnamed: R20.1, TOUCH.10 (CS6/GPO2), TP22.1
unnamed: R21.1, TOUCH.12 (CS2/GUARD), TP23.1
unnamed: R22.1, TOUCH.13 (CS3), TP24.1
unnamed: R23.1, TOUCH.11 (CS7/GPO3/SH), TP25.1
unnamed: R24.2, TOUCH.8 (CS4/GPO0)
unnamed: R25.2, TOUCH.9 (CS5/GPO1)
unnamed: R26.2, TOUCH.1 (CS0/PS0)
unnamed: R27.2, TOUCH.2 (CS1/PS1)
unnamed: TOUCH.7 (VSS), TOUCH.17 (EP)
TOUCH0: EDGE_CONNECTOR.20, R26.1
TOUCH1: EDGE_CONNECTOR.19, R27.1
TOUCH2: EDGE_CONNECTOR.14, R21.2
TOUCH3: EDGE_CONNECTOR.13, R22.2
TOUCH4: EDGE_CONNECTOR.18, R24.1
TOUCH5: EDGE_CONNECTOR.17, R25.1
TOUCH6: EDGE_CONNECTOR.16, R20.2
TOUCH7: EDGE_CONNECTOR.15, R23.2

Notes on the sheet:
Address = 0x37
