littleweirdo-studio/little-squeaky-machine-hardware/fabrication/v4/kicad_little_squeaky_machine/8_Gyro Control.kicad_sch

## KiCad design fabrication/v4/kicad_little_squeaky_machine/8_Gyro Control.kicad_sch (2026-11-06)

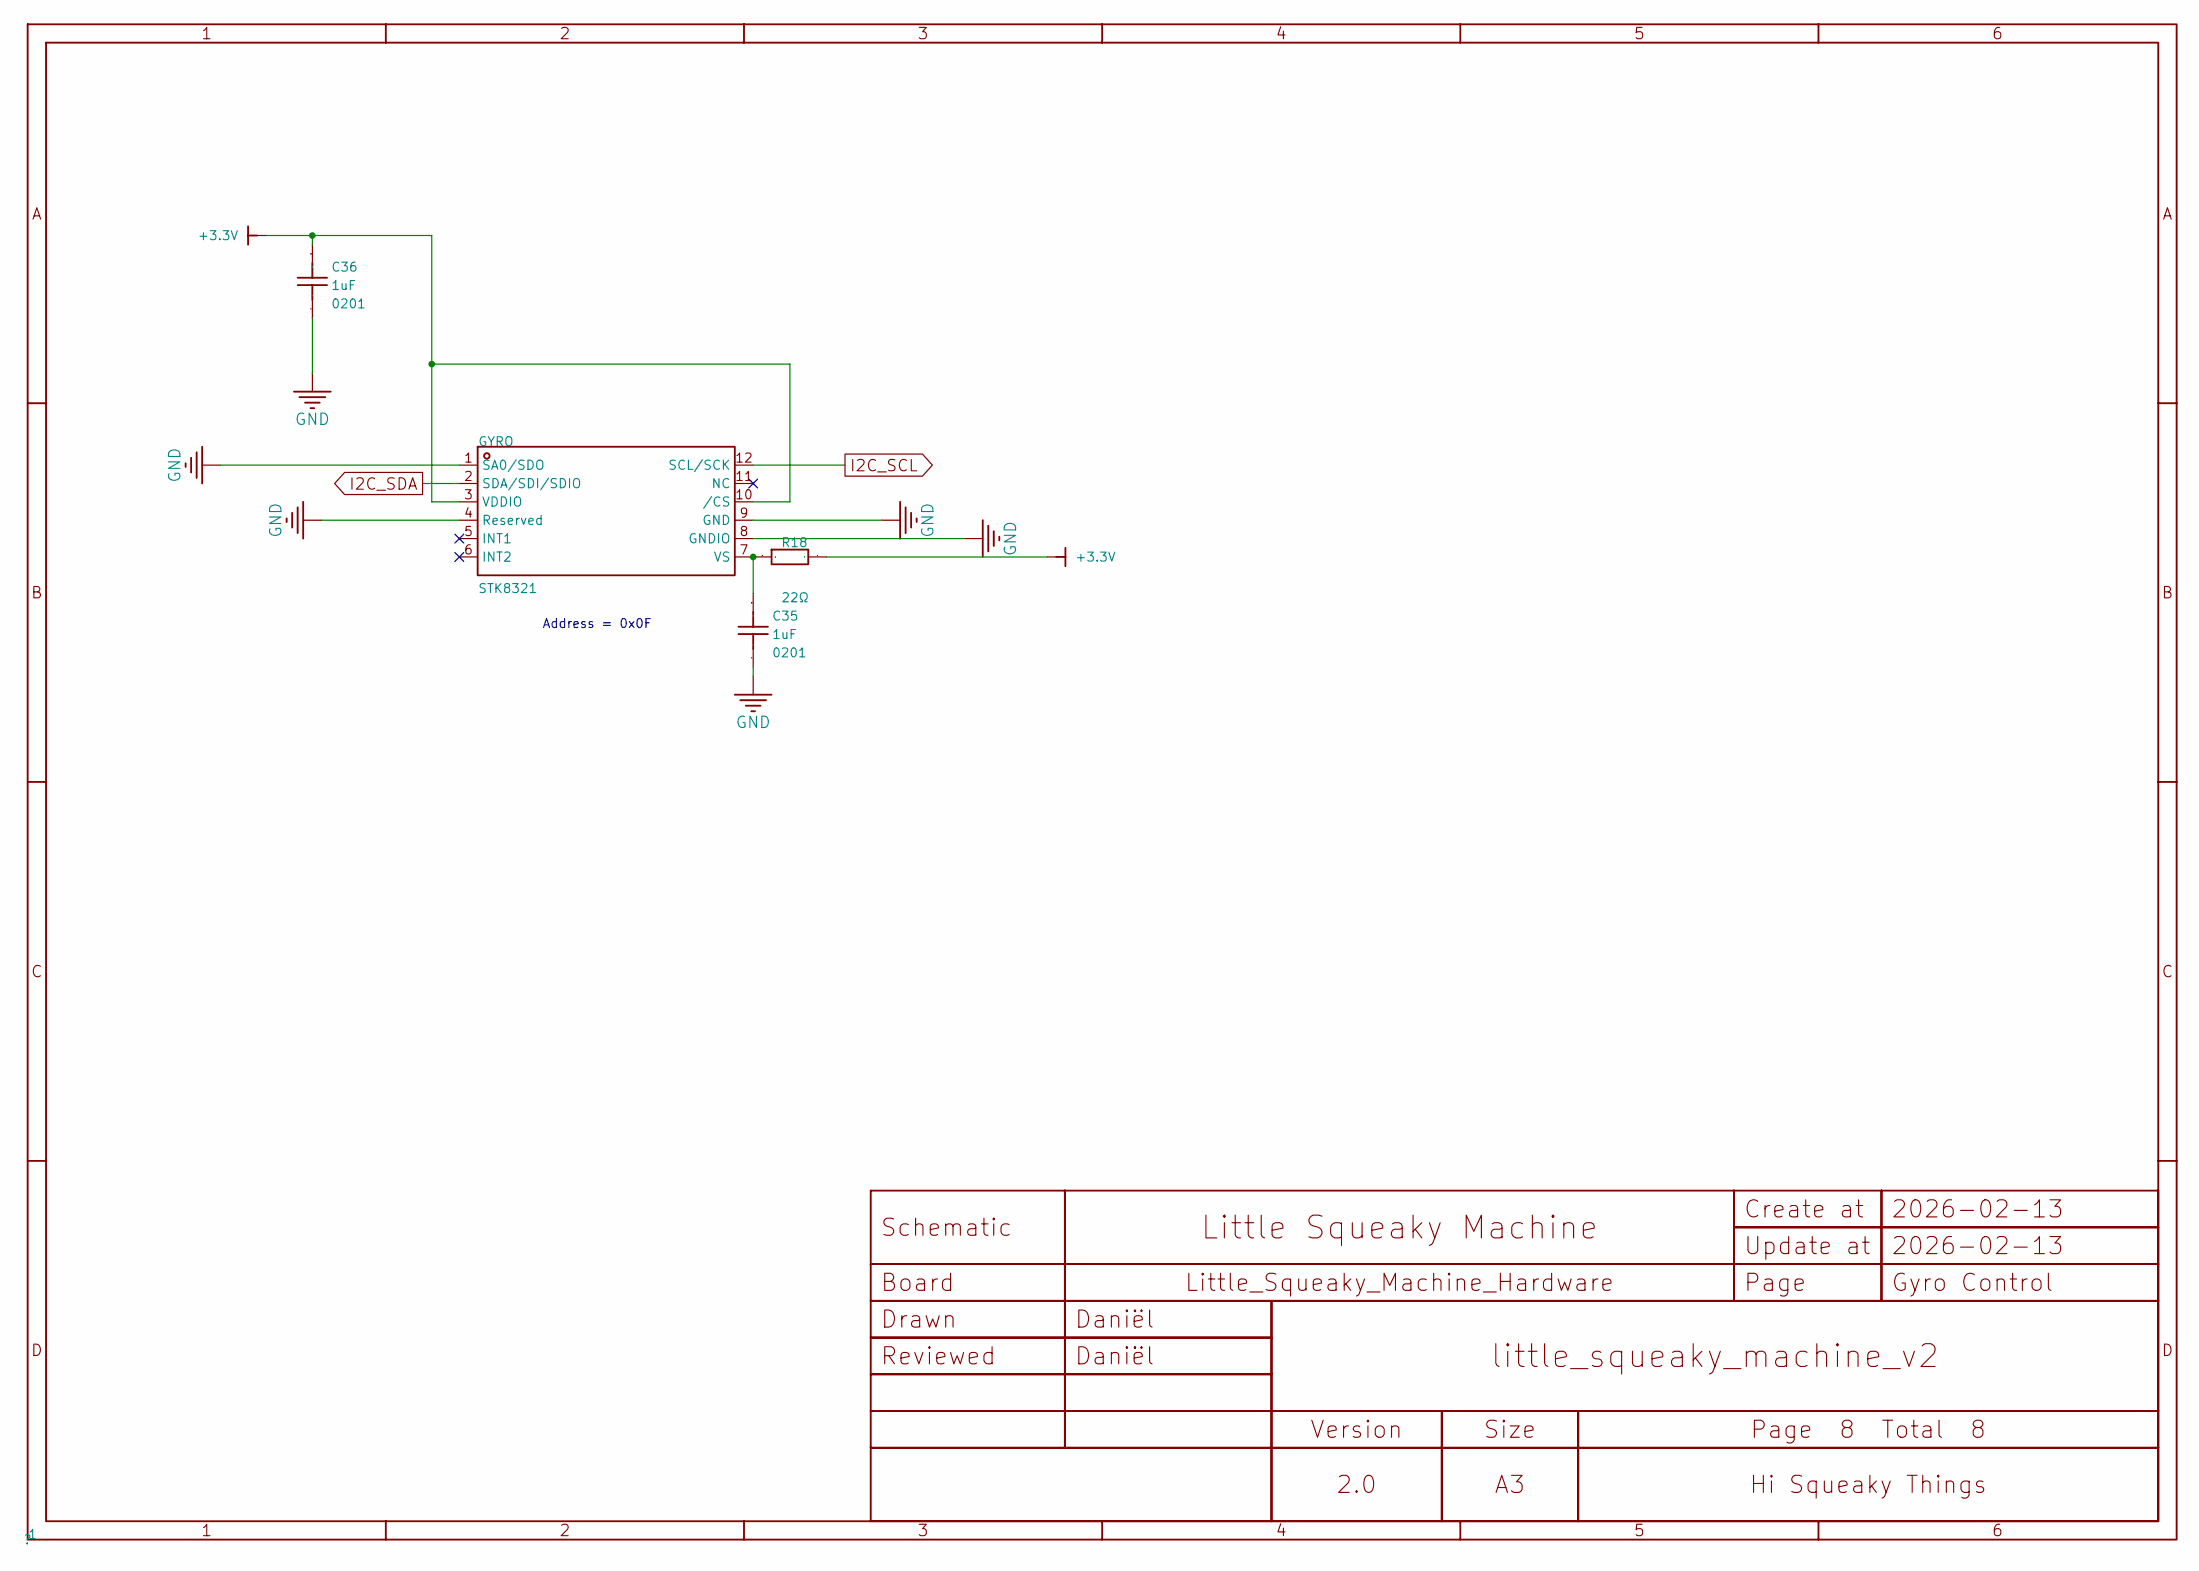
[picture p25: schematic 8_Gyro Control.kicad_sch]

Parts:
C35, C36: 1uF; C0603; Manufacturer Part GRM033R61A105ME44D; LCSC Part Name 1uF ±20% 10V
GYRO: STK8321; LGA-12_L2.0-W2.0-P0.50-TR; Manufacturer Part STK8321; LCSC Part Name 数字输出三轴MEMS加速度计
R18: 22Ω; R0603; Tolerance ±1%; Manufacturer Part 0603WAF220JT5E; LCSC Part Name 22Ω ±1% 100mW 厚膜电阻

Connections:
I2C_SCL: GYRO.12 (SCL/SCK)
I2C_SDA: GYRO.2 (SDA/SDI/SDIO)
unnamed: C35.1, GYRO.7 (VS), R18.1
unnamed: C36.1, GYRO.3 (VDDIO), GYRO.10 (/CS)

Notes on the sheet:
Address = 0x0F
