littleweirdo-studio/little-squeaky-machine-hardware/(commit log)

2026-11-06 3.0 (#2)
    * update README.md for revision 3.0 with new caution note, rendered images, and documentation links
    [1_Processing.kicad_sch, 2_Audio Codec.kicad_sch, 3_Led Controls.kicad_sch, 4_Key Matrix Controls.kicad_sch, 5_Pot and Encoder Controls.kicad_sch, 6_Midi In{slash}Out.kicad_sch, 7_Touch control.kicad_sch, 8_Gyro Control.kicad_sch]
2026-11-06 Add PCB image for revision 4.0
    Added image for revision 4.0 PCB.
2026-11-07 add the old versions, for archive purposes and easy access
    [bom.xlsx, bottom.stl, little_squeaky_machine.eprj, little_squeaky_machine.epro, pickandplace.xlsx, top.stl]
