littleweirdo-studio/little-squeaky-machine-hardware/(notices)

Notices in the files:
README.md:
CC BY-NC-SA 4.0
